ImperialSpaceSociety/Flight-Computer/Hardware/Documentation/Pinout_Stm32.xlsx

Module
Radio
PA0 | Radio_DIO1
PA1 | Radio_DIO0
PC1 | Radio_DIO2
PC8 | Radio_DIO3
PC7 | Radio_DIO4
PC6 | Radio_DIO5
PA2 | Radio_RX
PA4 | Radio_TX
PA5 | Radio_SPI1_SCK
PA6 | Radio_SPI1_MISO
PA7 | Radio_SPI1_MOSI
PC5 | Radio_Enable
SWD
PA13 | SYS_JTMS_SWDIO
PA14 | SYS_JTCK_SWCLK
Flash
PB2 | Flash_QUADSPI_CLK
PB6 | Flash_QUADSPI_BK1_NCS
PC9 | Flash_QUADSPI_BK1_IO0
PC10 | Flash_QUADSPI_BK1_IO1
GPS
PC11 | GPS_Reset
PC12 | GPS_UART_TX
PD2 | GPS_UART_RX
Indicator LED
PB9 | Indicator_LED
Battery Voltage Measurement
PC4 | Battery_Voltage
Buzzer
PA3 | Buzzer_Gate
USB
PA11 | USB_D-
PA12 | USB_D+
I2C
PB7 | I2C1_SDA
PB8 | I2C1_SCL
BMI088
PC14 | Acc_int1
PC15 | Gyro_int3
LIS3MDL
PA8 | Mag_Data_Ready
