ImperialSpaceSociety/Flight-Computer/Software/serial_logging/processing/Altitude.png

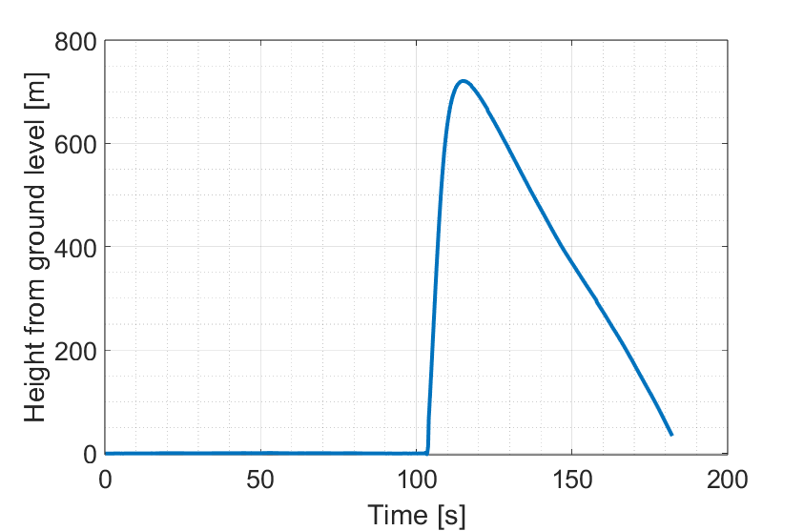
Software/serial_logging/processing/Altitude.png
