ImperialSpaceSociety/Flight-Computer/Software/serial_logging/processing/Distance.png

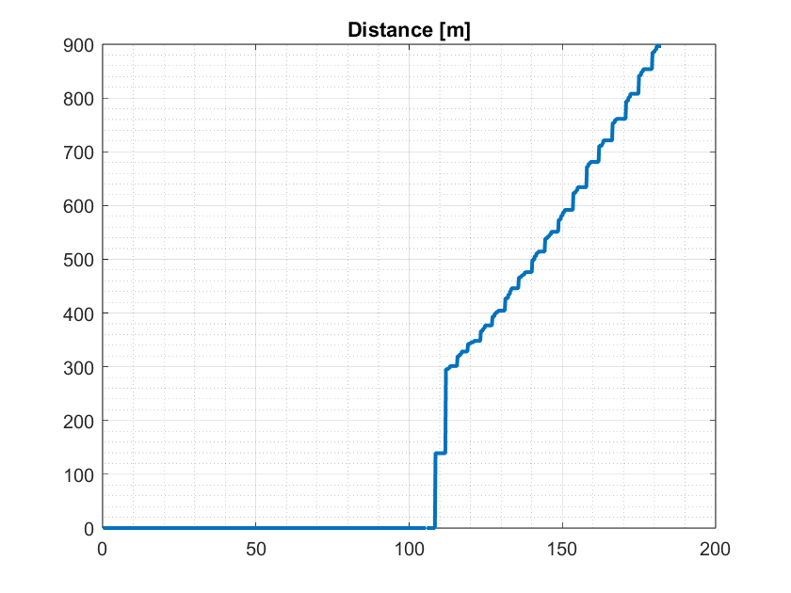
Software/serial_logging/processing/Distance.png
