ImperialSpaceSociety/Flight-Computer/Software/serial_logging/processing/Humidity.png

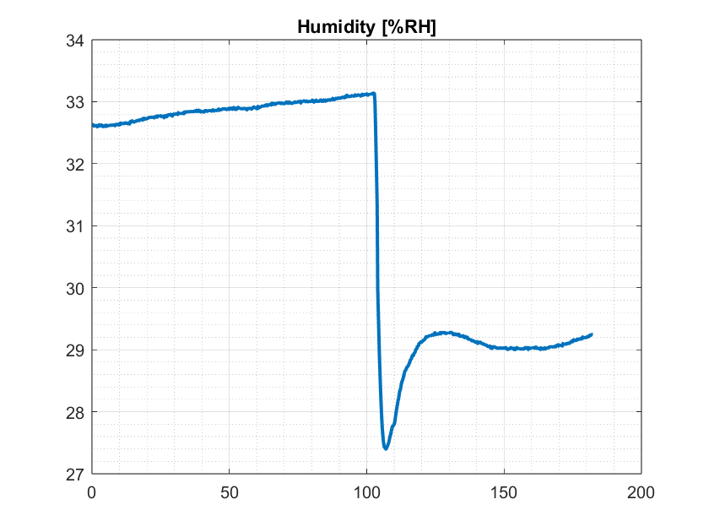
Software/serial_logging/processing/Humidity.png
