ImperialSpaceSociety/Flight-Computer/Software/serial_logging/processing/Map.png

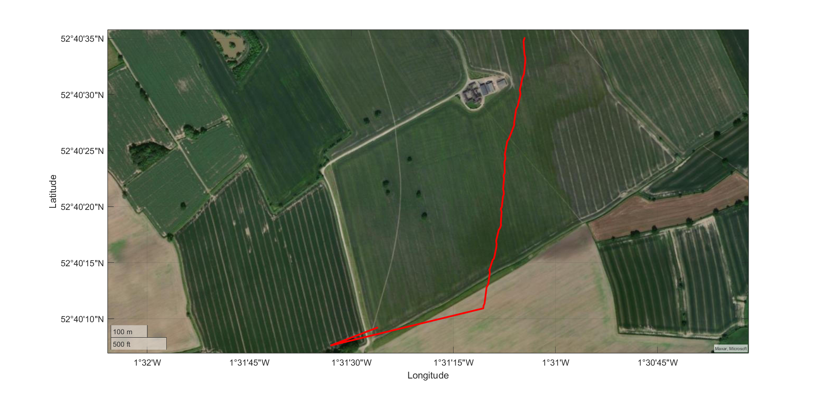
Software/serial_logging/processing/Map.png
