ImperialSpaceSociety/Flight-Computer/Software/serial_logging/processing/MapV2.png

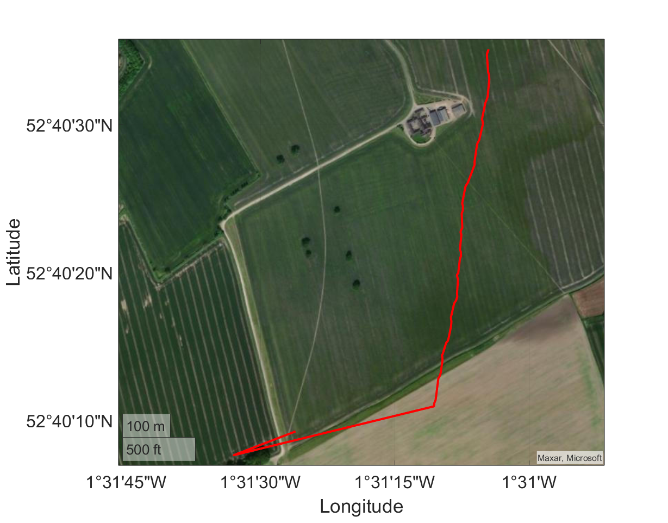
Software/serial_logging/processing/MapV2.png
