ImperialSpaceSociety/Flight-Computer/Software/serial_logging/processing/Pressure.png

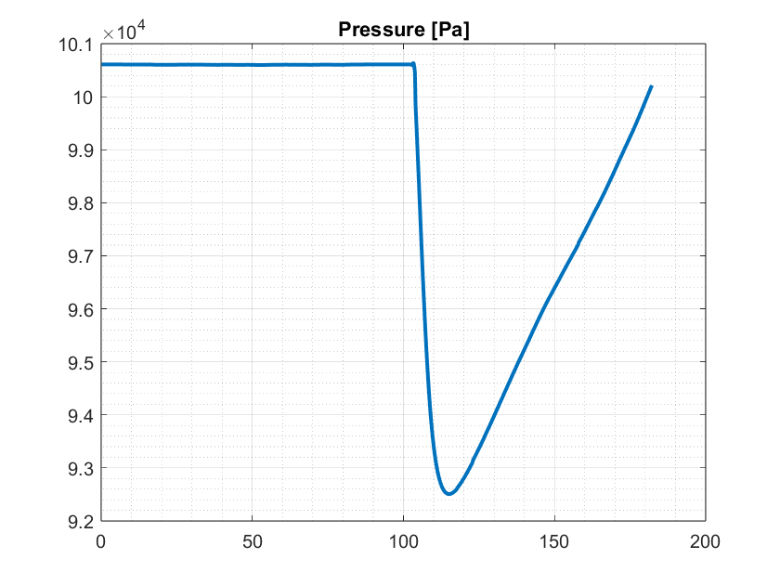
Software/serial_logging/processing/Pressure.png
