ImperialSpaceSociety/Flight-Computer/Software/serial_logging/processing/Temperature.png

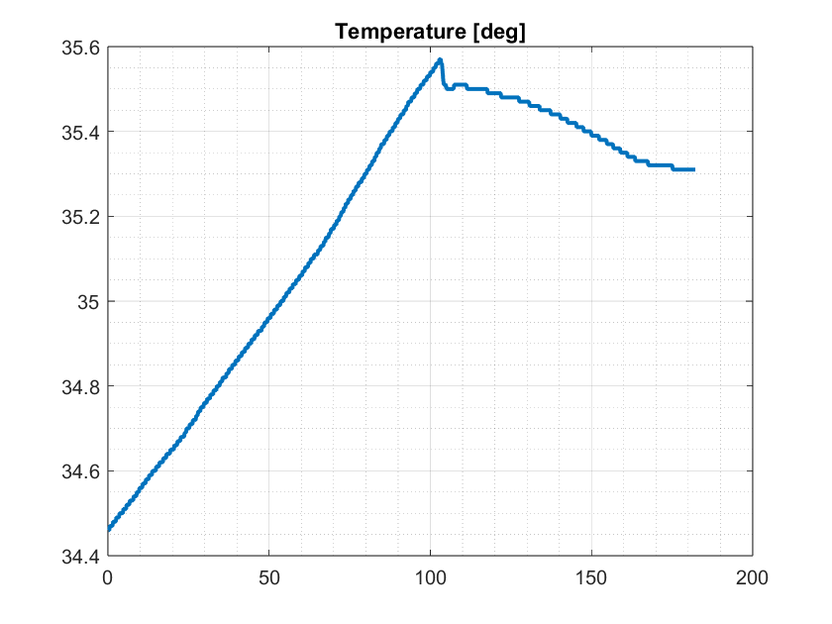
Software/serial_logging/processing/Temperature.png
