ImperialSpaceSociety/Flight-Computer/Hardware/Documentation/Bill_of_materials.xlsx

Sheet: circuit board design v2.1
Source: | C:\Users\timot\Documents\Programming\SpaceSoc\Flight-Computer\Hardware\circuit board design v2.1\circuit board design v2.1.kicad_sch
Date: | 2023-06-03 15:34
Tool: | Eeschema (6.0.8)
Generator: | C:\Program Files\KiCad\6.0\bin\scripting\plugins/bom_csv_grouped_by_value.py
Component Count: | 56
Individual Components:
Item | Qty | Reference(s) | Value | LibPart | Footprint | Datasheet | AVAILABILITY | Arrow Part Number | Arrow Price/Stock | DESCRIPTION | Datasheet_1 | Description | Footprint_1 | Height | MANUFACTURER | MAXIMUM_PACKAGE_HEIGHT | MF | MP | Manufacturer_Name | Manufacturer_Part_Number | Mouser Part Number | Mouser Price/Stock | PACKAGE | PARTREV | PRICE | Reference_1 | SNAPEDA_PACKAGE_ID | SNAPEDA_PN | STANDARD | Value_1
 |  | C1 | 100nF | Components:C_0603 | Components:C_0603_1608Metric | ~
 |  | C2 | 100nF | Components:C_0603 | Components:C_0603_1608Metric | ~
 |  | C3 | 1uF | Components:C_0603 | Components:C_0603_1608Metric | ~
 |  | C4 | 1uF | Components:C_0603 | Components:C_0603_1608Metric | ~
 |  | C5 | 100nF | Components:C_0603 | Components:C_0603_1608Metric | ~
 |  | C6 | 100nF | Components:C_0603 | Components:C_0603_1608Metric | ~
 |  | C7 | 100nF | Components:C_0603 | Components:C_0603_1608Metric | ~
 |  | C8 | 100nF | Components:C_0603 | Components:C_0603_1608Metric | ~
 |  | C9 | 4.7uF | Components:C_0603 | Components:C_0603_1608Metric | ~
 |  | C10 | 100nF | Components:C_0603 | Components:C_0603_1608Metric | ~
 |  | C11 | 1uF | Components:C_0603 | Components:C_0603_1608Metric | ~
 |  | C12 | 1uF | Components:C_0603 | Components:C_0603_1608Metric | ~
 |  | C13 | 100nF | Components:C_0603 | Components:C_0603_1608Metric | ~
 |  | C14 | 100nF | Components:C_0603 | Components:C_0603_1608Metric | ~
 |  | C15 | 100nF | Components:C_0603 | Components:C_0603_1608Metric | ~
 |  | C16 | 4.7uF Tantalum Capacitor | Device:C_Polarized_Small | Capacitor_SMD:C_1206_3216Metric_Pad1.33x1.80mm_HandSolder | ~
 |  | C17 | 15pF | Components:C_0603 | Components:C_0603_1608Metric | ~
 |  | C18 | 15pF | Components:C_0603 | Components:C_0603_1608Metric | ~
 |  | C19 | 100nF | Components:C_0603 | Components:C_0603_1608Metric | ~
 |  | C20 | 100nF | Components:C_0603 | Components:C_0603_1608Metric | ~
 |  | C21 | 100nF | Components:C_0603 | Components:C_0603_1608Metric | ~
 |  | C22 | 4.7uF | Components:C_0603 | Components:C_0603_1608Metric | ~
 |  | C23 | 100nF | Components:C_0603 | Components:C_0603_1608Metric | ~
 |  | C24 | 100nF | Components:C_0603 | Components:C_0603_1608Metric | ~
 |  | C27 | 100nF | Device:C_Small | Capacitor_SMD:C_0603_1608Metric_Pad1.08x0.95mm_HandSolder | ~
 |  | D1 | DFLS130L Schottkey Diode | Components:DFLS130L | Components:PowerDI123 | ~
 |  | D2 | DFLS130L Schottkey Diode | Components:DFLS130L | Components:PowerDI123 | ~
 |  | D3 | SML-LX0603GW-TR Green LED | Components:LED_0603 | Components:C_0603_1608Metric | ~
 |  | D4 | SML-LX0603IW-TR Red LED | Components:LED_0603 | Components:C_0603_1608Metric | ~
 |  | FB1 | 742792025 Ferrite Bead 120R@100MHz | Device:FerriteBead | Resistor_SMD:R_0805_2012Metric_Pad1.20x1.40mm_HandSolder | ~
 |  | J1 | 01x02_Male_PinHeader_2.54mm | Connector:Conn_01x02_Male | Connector_PinHeader_2.54mm:PinHeader_1x02_P2.54mm_Vertical | ~
 |  | J2 | JST_PH_S2B-PH-K_1x02_P2.00mm_Horizontal | Connector_Generic:Conn_01x02 | Components:JST_PH_S2B-PH-K_1x02_P2.00mm_Horizontal | ~
 |  | J3 | 105017-0001 Micro USB Conn | Components:105017-0001 | MOLEX_105017-0001 | https://www.mouser.co.uk/datasheet/2/276/1/1050170001_IO_CONNECTORS-230168.pdf
 |  | J4 | [OPTIONAL] U.FL-R-SMT-1_10_ Antenna Conn | Components:U.FL-R-SMT-1_10_ | Components:U.FL-R-SMT-1_10_ | https://www.hirose.com/product/document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 |  | U.FL-R-SMT-1(10) | https://www.arrow.com/en/products/u.fl-r-smt-1-10/hirose-electric |  | https://www.hirose.com/product/document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 |  | U.FL-R-SMT-1(10) |  |  |  |  |  | Hirose | U.FL-R-SMT-1(10) | 798-U.FL-R-SMT-110 | https://www.mouser.co.uk/ProductDetail/Hirose-Connector/U.FL-R-SMT-110?qs=kL1ClTr6oBoOdtqlGQpQrQ%3D%3D |  |  |  | J |  |  |  | U.FL-R-SMT-1_10_
 |  | J6 | 01x02_Male_PinHeader_2.54mm | Connector:Conn_01x02_Male | Connector_PinHeader_2.54mm:PinHeader_1x02_P2.54mm_Vertical | ~
 |  | R1 | 100k | Components:R_0603 | Components:R_0603_1608Metric | ~
 |  | R2 | 100k | Components:R_0603 | Components:R_0603_1608Metric | ~
 |  | R3 | 100 | Components:R_0603 | Components:R_0603_1608Metric | ~
 |  | R4 | 100 | Components:R_0603 | Components:R_0603_1608Metric | ~
 |  | R5 | 4.7k | Components:R_0603 | Components:R_0603_1608Metric | ~
 |  | R6 | 3.3k | Components:R_0603 | Components:R_0603_1608Metric | ~
 |  | R7 | 4.7k | Components:R_0603 | Components:R_0603_1608Metric | ~
 |  | R8 | 4.7k | Components:R_0603 | Components:R_0603_1608Metric | ~
 |  | U1 | STM32F446RETx | MCU_ST_STM32F4:STM32F446RETx | Components:LQFP-64_10x10mm_P0.5mm | http://www.st.com/st-web-ui/static/active/en/resource/technical/document/datasheet/DM00141306.pdf
 |  | U2 | W25Q64JVSS 64MBit Flash Chip | Components:W25Q64JVSS | Components:W25Q64JVSSIQ | https://www.winbond.com/resource-files/W25Q64JV%20RevK%2003102021%20Plus.pdf#toolbar=0
 |  | U3 | SDR08540M3-01 SMD Buzzer | Components:SDR08540M3-01 | Components:SDR08540M3-01 Buzzer | https://docs.rs-online.com/16ce/0900766b815934ae.pdf
 |  | U4 | BME280 Environment Sensor | Sensor:BME280 | Package_LGA:Bosch_LGA-8_2.5x2.5mm_P0.65mm_ClockwisePinNumbering | https://ae-bst.resource.bosch.com/media/_tech/media/datasheets/BST-BME280-DS002.pdf
 |  | U5 | STF202-22T1G ESD/EMI Chip | Components:STF202-22T1G | Components:STF202-22T1G
 |  | U6 | MAX40203_SOT23 Ideal Diode | Components:MAX40203_SOT23 | Package_TO_SOT_SMD:SOT-23-5
 |  | U7 | NCP161ASN330T1G LDO | Components:NCP161ASN180T1G | Components:SOT95P280X145-5N | https://www.mouser.co.uk/datasheet/2/308/1/NCP161_D-2316989.pdf |  |  |  |  |  |  |  |  | Onsemi | 1.45 mm |  |  |  |  |  |  |  | Rev. 18 |  |  |  | NCP161ASN180T1G | IPC-7351B
 |  | U8 | BMI088 Inertial Measurement Unit | Components:BMI088 | Components:BMI088 | https://datasheet.datasheetarchive.com/originals/distributors/Datasheets_SAMA/994c3bf88e91a9e9fead6a819d348e4d.pdf |  | BMI088 | https://www.arrow.com/en/products/bmi088/bosch?region=europe |  |  | Inertial Measurement Unit Digital Output 2.5V/3.3V Automotive |  | 1.45 |  |  |  |  | BOSCH | BMI088 | 262-BMI088 | https://www.mouser.co.uk/ProductDetail/Bosch-Sensortec/BMI088?qs=f9yNj16SXrIMFspTV6RB6Q%3D%3D
 |  | U9 | LIS3MDLTR Magnetometer | Components:LIS3MDLTR | Components:XDCR_LIS3MDLTR |  | Unavailable |  |  | LIS3MDL Series 3 Axis Â±2/Â±8/Â±12/Â±16 g 3.6V High Performance Magnetometer LGA-12 |  |  |  |  |  | 1mm | STMicroelectronics | LIS3MDLTR |  |  |  |  | VFLGA-12 STMicroelectronics | 6 | None |  |  |  | Manufacturer Recommendation
 |  | U10 | LAMBDA-9D Radio | Components:LAMBDA-9D | Components:XCVR_LAMBDA-9D |  |  |  |  |  |  |  |  |  | RF Solutions | 5.81 mm |  |  |  |  |  |  |  | N/A |  |  | 63698 | LAMBDA-9D | Manufacturer Recommendations
 |  | U11 | 2SCR512R_HZG BJT | Components:2SCR512R_HZG | Components:2SCR512RHZG | https://fscdn.rohm.com/en/products/databook/datasheet/discrete/transistor/bipolar/2scr512rhzgtl-e.pdf
 |  | U12 | L80-R GPS | Components:L80-R | Components:Quectel_L80-R | https://www.quectel.com/UploadImage/Downlad/Quectel_L80-R_Hardware_Design_V1.2.pdf
 |  | Y1 | ECS-80-8-33Q-ADS-TR3 8MHz Crystal | Device:Crystal_GND24 | Components:ECS-80-8-33Q-ADS-TR3 Crystal | ~
Collated Components:
Item | Qty | Reference(s) | Value |  |  |  |  |  |  |  |  |  |  |  |  |  |  |  |  |  |  |  |  |  |  |  |  |  | STANDARD | Value_1
1 | 15 | C1, C2, C5, C6, C7, C8, C10, C13, C14, C15, C19, C20, C21, C23, C24 | 100nF
2 | 4 | C3, C4, C11, C12 | 1uF
3 | 2 | C9, C22 | 4.7uF
4 | 1 | C16 | 4.7uF Tantalum Capacitor
5 | 2 | C17, C18 | 15pF
6 | 1 | C27 | 100nF
7 | 2 | D1, D2 | DFLS130L Schottkey Diode
8 | 1 | D3 | SML-LX0603GW-TR Green LED
9 | 1 | D4 | SML-LX0603IW-TR Red LED
10 | 1 | FB1 | 742792025 Ferrite Bead 120R@100MHz
11 | 2 | J1, J6 | 01x02_Male_PinHeader_2.54mm
12 | 1 | J2 | JST_PH_S2B-PH-K_1x02_P2.00mm_Horizontal
13 | 1 | J3 | 105017-0001 Micro USB Conn
14 | 1 | J4 | [OPTIONAL] U.FL-R-SMT-1_10_ Antenna Conn
15 | 2 | R1, R2 | 100k
16 | 2 | R3, R4 | 100
17 | 3 | R5, R7, R8 | 4.7k
18 | 1 | R6 | 3.3k
19 | 1 | U1 | STM32F446RETx
20 | 1 | U2 | W25Q64JVSS 64MBit Flash Chip
21 | 1 | U3 | SDR08540M3-01 SMD Buzzer
22 | 1 | U4 | BME280 Environment Sensor
23 | 1 | U5 | STF202-22T1G ESD/EMI Chip
24 | 1 | U6 | MAX40203_SOT23 Ideal Diode
25 | 1 | U7 | NCP161ASN330T1G LDO
26 | 1 | U8 | BMI088 Inertial Measurement Unit
27 | 1 | U9 | LIS3MDLTR Magnetometer
28 | 1 | U10 | LAMBDA-9D Radio
29 | 1 | U11 | 2SCR512R_HZG BJT
30 | 1 | U12 | L80-R GPS
31 | 1 | Y1 | ECS-80-8-33Q-ADS-TR3 8MHz Crystal

Sheet: Collated items
Item | Qty | Reference(s) | Value | Link | Unit cost | No. required | No. available | No. to purchase | No. expected | Price for part | Ordered? | Received?
1 | 15 | C1, C2, C5, C6, C7, C8, C10, C13, C14, C15, C19, C20, C21, C23, C24 | 100nF 0603YC104J4T4A | https://www.mouser.co.uk/ProductDetail/KYOCERA-AVX/0603YC104J4T4A?qs=Cej1j9ztgjFyuPBXcKRKGA%3D%3D | 0.131 | 45 | 19 | 30 | 49 | 3.93 | Yes
2 | 4 | C3, C4, C11, C12 | 1uF |  |  | 12 | 50 | 0 | 50 | 0
3 | 2 | C9, C22 | 4.7uF | https://www.mouser.co.uk/ProductDetail/KYOCERA-AVX/0603YW475KAT2A?qs=iLbezkQI%252BsjdoT7nJYA5eA%3D%3D |  | 6 | 15 | 0 | 15 | 0
4 | 1 | C16 | 4.7uF Tantalum Capacitor | https://www.mouser.co.uk/ProductDetail/KYOCERA-AVX/TPSA475M010R1400?qs=70AbZ74NqZZa2PI6j%2F762Q%3D%3D |  | 3 | 18 | 0 | 18 | 0
5 | 2 | C17, C18 | 15pF 06031A150FAT2A | https://www.mouser.co.uk/ProductDetail/KYOCERA-AVX/06031A150FAT2A?qs=xLQ2B4dN2oaD6%252BZaTtyi8g%3D%3D | 0.175 | 6 | 0 | 10 | 10 | 1.75 | Yes
6 | 1 | C27 | 100nF |  |  | 3 | 3 | 0 | 3 | 0
7 | 2 | D1, D2 | DFLS130L Schottkey Diode | https://www.mouser.co.uk/ProductDetail/Diodes-Incorporated/DFLS130L-7?qs=JV7lzlMm3yLedTETABmZ1A%3D%3D | 0.372 | 6 | 43 | 0 | 43 | 0
8 | 1 | D3 | SML-LX0603GW-TR Green LED | https://www.mouser.co.uk/ProductDetail/Lumex/SML-LX0603GW-TR?qs=Ma3pWdXK8s%252BAlupi7PYUJg%3D%3D | 0.181 | 3 | 0 | 10 | 10 | 1.81 | Yes
9 | 1 | D4 | SML-LX0603IW-TR Red LED | https://www.mouser.co.uk/ProductDetail/Lumex/SML-LX0603IW-TR?qs=Ma3pWdXK8s%2FPxoga78z1xA%3D%3D | 0.173 | 3 | 0 | 10 | 10 | 1.73 | Yes
10 | 1 | FB1 | 742792025 Ferrite Bead 120R@100MHz | https://www.mouser.co.uk/ProductDetail/Wurth-Elektronik/742792025?qs=amGC7iS6iy%252BaTNFi8olptQ%3D%3D | 0.19 | 3 | 7 | 0 | 7 | 0
11 | 2 | J1, J6 | 01x02_Male_PinHeader_2.54mm |  |  | 6 | 40 | 0 | 40 | 0
12 | 1 | J2 | JST_PH_S2B-PH-K_1x02_P2.00mm_Horizontal | https://www.mouser.co.uk/ProductDetail/SparkFun/PRT-09749 | 0.786 | 3 | 0 | 5 | 5 | 3.93 | Yes
13 | 1 | J3 | 105017-0001 Micro USB Conn | https://www.mouser.co.uk/ProductDetail/Molex/105017-0001?qs=hlXxxvYE36k7QcsR97GUKA%3D%3D | 0.769 | 3 | 0 | 3 | 3 | 2.307 | Yes
14 | 1 | J4 | [OPTIONAL] U.FL-R-SMT-1_10_ Antenna Conn | https://www.mouser.co.uk/ProductDetail/Hirose-Connector/U.FL-R-SMT-110?qs=kL1ClTr6oBoOdtqlGQpQrQ%3D%3D | 1.04 | 3 | 0 | 3 | 3 | 3.12 | Yes
15 | 2 | R1, R2 | 100k | https://www.mouser.co.uk/ProductDetail/Bourns/CR0603AFX-1003EAS?qs=PzGy0jfpSMt3RNxQD3lIYw%3D%3D | 0.083 | 6 | 16 | 0 | 16 | 0
16 | 2 | R3, R4 | 100 | https://www.mouser.co.uk/ProductDetail/ROHM-Semiconductor/ESR03EZPF1000?qs=493kPxzlxfJdLkJZpX4ByA%3D%3D | 0.106 | 6 | 0 | 10 | 10 | 1.06 | Yes
17 | 3 | R5, R7, R8 | 4.7k |  |  | 9 | 35 | 0 | 35 | 0
18 | 1 | R6 | 3.3k |  |  | 3 | 50 | 0 | 50 | 0
19 | 1 | U1 | STM32F446RET6 MCU | https://www.mouser.co.uk/ProductDetail/511-STM32F446RET6 | 10.02 | 3 | 0 | 3 | 3 | 30.06 | Yes
20 | 1 | U2 | W25Q64JVSSIM 64MBit Flash Chip | https://www.mouser.co.uk/ProductDetail/Winbond/W25Q64JVSSIM?qs=qSfuJ%252Bfl%2Fd7U0hcTKxbcpQ%3D%3D | 0.924 | 3 | 1 | 3 | 4 | 2.772 | Yes
21 | 1 | U3 | SDR08540M3-01 SMD Buzzer | https://www.mouser.co.uk/ProductDetail/TDK/SDR08540M3-01?qs=HCSEz3Yk0hVXXjPeUNGg%252Bw%3D%3D | 2.79 | 3 | 0 | 3 | 3 | 8.37 | Yes
22 | 1 | U4 | BME280 Environment Sensor | https://www.mouser.co.uk/ProductDetail/Bosch-Sensortec/BME280?qs=2OnyuXx6vpj2fK9HX7qb3g%3D%3D | 5.36 | 3 | 0 | 3 | 3 | 16.08 | Yes
23 | 1 | U5 | STF202-22T1G ESD/EMI Chip | https://www.mouser.co.uk/ProductDetail/onsemi/STF202-22T1G?qs=xZq1yRCsb1dM1UQ1NtNRtw%3D%3D | 0.472 | 3 | 0 | 5 | 5 | 2.36 | Yes
24 | 1 | U6 | MAX40203AUK+T Ideal Diode | https://www.mouser.co.uk/ProductDetail/Analog-Devices-Maxim-Integrated/MAX40203AUK%2bT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 | 0.959 | 3 | 0 | 5 | 5 | 4.795 | Yes
25 | 1 | U7 | NCP161ASN330T1G LDO | https://www.mouser.co.uk/ProductDetail/onsemi/NCP161ASN330T1G?qs=vLWxofP3U2ze5zA%252BHmAd3w%3D%3D | 0.554 | 3 | 0 | 5 | 5 | 2.77 | Yes
26 | 1 | U8 | BMI088 Inertial Measurement Unit | https://www.mouser.co.uk/ProductDetail/Bosch-Sensortec/BMI088?qs=f9yNj16SXrIMFspTV6RB6Q%3D%3D | 6.91 | 3 | 0 | 3 | 3 | 20.73 | Yes
27 | 1 | U9 | LIS3MDLTR Magnetometer | https://www.mouser.co.uk/ProductDetail/STMicroelectronics/LIS3MDLTR?qs=hnsWAVXnr6EbLE48dGN9Pg%3D%3D | 3.79 | 3 | 0 | 3 | 3 | 11.37 | Yes
28 | 1 | U10 | LAMBDA-9D Radio | https://uk.farnell.com/rf-solutions/lambda-9s/rf-transceiver-module-300kbps/dp/2841160 | 17.13 | 3 | 0 | 3 | 3 | 51.39 | Yes
29 | 1 | U11 | 2SCR512RHZGTL BJT | https://www.mouser.co.uk/ProductDetail/ROHM-Semiconductor/2SCR512RHZGTL?qs=Znm5pLBrcALIry0mOIvBtQ%3D%3D | 0.579 | 3 | 0 | 5 | 5 | 2.895 | Yes
30 | 1 | U12 | L80-M39 GPS | https://www.digikey.com/en/products/detail/quectel/L80-M39/13278232 | 11.24 | 3 | 0 | 3 | 3 | 33.72 | Yes
31 | 1 | Y1 | ECS-80-8-33Q-ADS-TR3 8MHz Crystal | https://www.mouser.co.uk/ProductDetail/ECS/ECS-80-8-33Q-ADS-TR3?qs=vvQtp7zwQdPZhvH6k3gGMw%3D%3D | 0.803 | 3 | 0 | 5 | 5 | 4.015 | Yes
32 | 1 | - | Lipo battery | https://www.amazon.co.uk/EEMB-Battery-Lithium-Rechargeable-connector/dp/B0B5LF57SL?hvadid=621166234518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 | 9.99 | 3 | 0 | 3 | 3 | 29.97
 |  |  |  |  |  |  |  |  |  | 240.934
JLCPCB | 38.12
