ImperialSpaceSociety/Flight-Computer/Hardware/Documentation/Power_consumption.xlsx

Sheet: Sheet1
Component | Name | Datasheet |  |  | manufacturer
IMU | BNO055 (9DOF)
 | BMI088 (6DOF, but better vibration resistance and lower drift) | https://download.mikroe.com/documents/datasheets/BMI088_Datasheet.pdf | Module (qty: 1) (https://www.mouser.co.uk/ProductDetail/Bosch-Sensortec/BMI088-Shuttle-Board-3.0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) |  | Module (qty: 1)
Magnetometer | LIS3MDL |  | Module (qty: 1) (https://www.mouser.co.uk/ProductDetail/Adafruit/4479?qs=CUBnOrq4ZJxLqbe7QDjUXQ%3D%3D)
Temp, Pressure, Humidity | BME280 | https://www.mouser.com/datasheet/2/783/BST-BME280-DS002-1509607.pdf
GPS | UBLOX MAX-M10 | Documentation (https://www.u-blox.com/en/product/max-m10-series)
 | Quectel L80-M39 | https://www.mouser.co.uk/datasheet/2/1052/QWSC_S_A0004134860_1-2576267.pdf | Module (qty: 1) (https://uk.rs-online.com/web/p/gnss-gps-modules/9084085)
Radio | LAMBDA-9P | Module (qty: 2) (https://uk.rs-online.com/web/p/lpwan/1812477) | Antenna (qty: 2) (https://uk.rs-online.com/web/p/telemetry-antennas/1767074) | SMA-IPEX Adapter (qty: 3) (https://uk.rs-online.com/web/p/coaxial-cable/1408015)
 | DIGI XTEND 1W (900Mhz)
Flash | W25Q64JV | Datasheet (https://www.winbond.com/resource-files/W25Q64JV%20RevK%2003102021%20Plus.pdf) | Chip (qty: 5) (https://www.mouser.co.uk/ProductDetail/Winbond/W25Q64JVSSIM?qs=qSfuJ%252Bfl%2Fd7U0hcTKxbcpQ%3D%3D) | Adapter (qty: 2) (https://www.mouser.co.uk/ProductDetail/Chip-Quik/PA0001?qs=gjT6naH6P5KNp1oSqw9XfQ%3D%3D)
Battery
Buzzer | TDK 88dB SMD High Internal Magnetic Buzzer Component | Link (https://docs.rs-online.com/16ce/0900766b815934ae.pdf)
MCU | STM32F446RE | Documentation (https://www.st.com/en/microcontrollers-microprocessors/stm32f446re.html)
 |  | Dev board (Nucleo) (https://www.mouser.co.uk/ProductDetail/511-NUCLEO-F446RE)

Sheet: BOM
Part | Price per unit | Quanitity | Price | Link | Number | Farnell link | Final check | Check if received | Not needed
STM32F446RET6 | 10.02 | 1 | 10.02 | https://www.mouser.co.uk/ProductDetail/511-STM32F446RET6 | 21 | https://uk.farnell.com/stmicroelectronics/stm32f446ret6/mcu-32bit-cortex-m4f-180mhz-lqfp/dp/2488310 | x | x | 13
SDR08540M3-01 | 2.79 | 1 | 2.79 | https://www.mouser.co.uk/ProductDetail/TDK/SDR08540M3-01?qs=HCSEz3Yk0hVXXjPeUNGg%252Bw%3D%3D | 23 |  | x | x | 16
BME280 | 5.36 | 1 | 5.36 | https://www.mouser.co.uk/ProductDetail/Bosch-Sensortec/BME280?qs=2OnyuXx6vpj2fK9HX7qb3g%3D%3D | 24 |  | x | x | 22 | Already bought the flash clip
STF202-22T1G | 0.472 | 1 | 0.472 | https://www.mouser.co.uk/ProductDetail/onsemi/STF202-22T1G?qs=xZq1yRCsb1dM1UQ1NtNRtw%3D%3D | 25 |  | x | x
MAX40203AUK+T | 0.959 | 1 | 0.959 | https://www.mouser.co.uk/ProductDetail/Analog-Devices-Maxim-Integrated/MAX40203AUK%2bT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 | 26 |  | x | x
NCP161ASN330T1G | 0.554 | 1 | 0.554 | https://www.mouser.co.uk/ProductDetail/onsemi/NCP161ASN330T1G?qs=vLWxofP3U2ze5zA%252BHmAd3w%3D%3D | 27 |  | x | x
L80-M39 | 12.65 | 1 | 12.65 | https://www.mouser.co.uk/ProductDetail/Quectel/L80-M39?qs=GedFDFLaBXEPqYfo45AE6g%3D%3D | 28 |  | x | Didn’t get it since it is only sold to business customers
LIS3MDLTR | 3.79 | 1 | 3.79 | https://www.mouser.co.uk/ProductDetail/STMicroelectronics/LIS3MDLTR?qs=hnsWAVXnr6EbLE48dGN9Pg%3D%3D | 29 | https://uk.farnell.com/stmicroelectronics/lis3mdltr/magnetic-sensor-4-8-12-16g-lga/dp/2433083 | x | x
ECS-80-8-33Q-ADS-TR3 | 0.803 | 1 | 0.803 | https://www.mouser.co.uk/ProductDetail/ECS/ECS-80-8-33Q-ADS-TR3?qs=vvQtp7zwQdPZhvH6k3gGMw%3D%3D | 30 |  | x | x
DFLS130L | 0.372 | 10 | 3.72 | https://www.mouser.co.uk/ProductDetail/Diodes-Incorporated/DFLS130L-7?qs=JV7lzlMm3yLedTETABmZ1A%3D%3D | 8 and 9 | https://uk.farnell.com/diodes-inc/dfls130lq-7/schottky-rect-single-30v-powerdi/dp/3127296?st=dfls130l | x | x
BMI088 | 6.91 | 1 | 6.91 | https://www.mouser.co.uk/ProductDetail/Bosch-Sensortec/BMI088?qs=f9yNj16SXrIMFspTV6RB6Q%3D%3D | 12 |  | x | x
2SCR512RHZGTL | 0.579 | 1 | 0.579 | https://www.mouser.co.uk/ProductDetail/ROHM-Semiconductor/2SCR512RHZGTL?qs=Znm5pLBrcALIry0mOIvBtQ%3D%3D | 17 |  | x | x
742792025 | 0.19 | 5 | 0.95 | https://www.mouser.co.uk/ProductDetail/Wurth-Elektronik/742792025?qs=amGC7iS6iy%252BaTNFi8olptQ%3D%3D | 10 | https://uk.farnell.com/wurth-elektronik/742792025/ferrite-bead-suppression-120-ohm/dp/4065718 | x | x
105017-0001 | 0.786 | 1 | 0.786 | https://www.mouser.co.uk/ProductDetail/Molex/105017-0001?qs=hlXxxvYE36k7QcsR97GUKA%3D%3D | 15 |  | x | x
U.FL-R-SMT-1(10) | 1.04 | 1 | 1.04 | https://www.mouser.co.uk/ProductDetail/Hirose-Connector/U.FL-R-SMT-110?qs=kL1ClTr6oBoOdtqlGQpQrQ%3D%3D |  |  | x | x
 |  |  | 0
4.7uF Capacitor 0603YW475KAT2A | 0.161 | 10 | 1.61 | https://www.mouser.co.uk/ProductDetail/KYOCERA-AVX/0603YW475KAT2A?qs=iLbezkQI%252BsjdoT7nJYA5eA%3D%3D | 3 |  | x | x
4.7uF Tantalum Capacitor TPSA475M010R1400 | 0.231 | 10 | 2.31 | https://www.mouser.co.uk/ProductDetail/KYOCERA-AVX/TPSA475M010R1400?qs=70AbZ74NqZZa2PI6j%2F762Q%3D%3D | 4 | https://uk.farnell.com/avx/tpsa475m010r1400/cap-4-7-f-10v-20/dp/2852790 | x | x
100k Resistor CR0603AFX-1003EAS | 0.033 | 10 | 0.33 | https://www.mouser.co.uk/ProductDetail/Bourns/CR0603AFX-1003EAS?qs=PzGy0jfpSMt3RNxQD3lIYw%3D%3D | 18 |  | x | x
EEMB Lithium Polymer battery 3.7V 600mAh 503042 Lipo Rechargeable Battery Pack with wire JST Connector | 7.89 | 1 | 7.89 | https://www.amazon.co.uk/dp/B095VW1RB8?s=electronics&sp_csd=d2lkZ2V0TmFtZT1zcF9kZXRhaWw
JST-PH 2 Wire Assembly | 0.6 | 5 | 3 | https://shop.pimoroni.com/products/jst-2-wire-assembly?variant=711377809&currency=GBP | 13
100nF Capacitors |  | 20 | 0 |  |  | https://uk.farnell.com/multicomp-pro/mcsh18b104k500ct/cap-0-1-f-50v-10-x7r-0603/dp/1856385 | x | x
 |  |  | 0
 |  |  | 0
 |  |  | 0
 |  |  | 0
 |  |  | 66.523
Existing parts (All parts 0603 exept if specified otherwise)
4.7k Resistor |  | Plenty |  |  | 19
3.3k Resistor |  | Plenty
15pF Capacitor |  | Some |  |  | 5
100nF Capacitor |  | Plenty |  |  | 1
10uF Capacitor |  | Plenty
33nF Capacitor |  | Plenty
1uF Capacitor |  | Plenty |  |  | 2,6,7
1 Resistor |  | Some

Sheet: power cossumption
Component | Voltage (V) | Current (mA) | Power (mW) | comment
BMI088 | 3.3 | 5.15 | 17.00
LIS3MDL | 3.3 | 0.27 | 0.89 | estimation the component might change
BME280 | 3.3 | 0.71 | 2.36 | (assuming measurement are done sequentially for temp, humidity and pressure
Quectel L80-M39 | 3.3 | 25.00 | 82.50
LAMBDA-9P (+17dBm PA Boost) | 3.3 | 90.00 | 297.00
W25Q64JV | 3.3 | 5.00 | 16.50
TDK 88dB | 3.3 | 85.00 | 280.50
STM32F446RE (90Mhz @ 25Deg) | 3.3 | 45.32 | 149.56
Total |  | 256.45 | 846.30
time of the flight | 1
Battery cap | 256.454
Calculating time of flight from batter cap | 187.1680691
