ImperialSpaceSociety/Flight-Computer/Hardware/circuit board design v2.1/Component_3d_models/SAM-M10Q-00B.stp

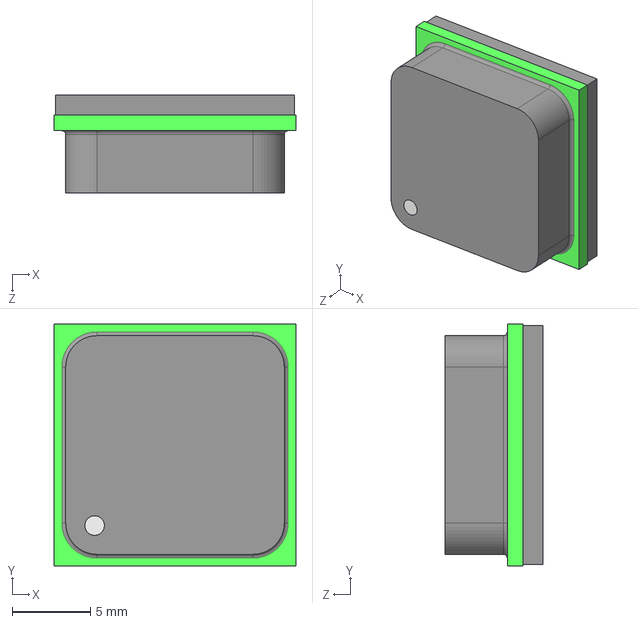
[picture p12: CAD file, 2023-05-27]
Hardware/circuit board design v2.1/Component_3d_models/SAM-M10Q-00B.stp
15.5 x 15.5 x 6.30 mm
