ImperialSpaceSociety/Flight-Computer/Hardware/enclosure/Electronics+Bay+V2+PCB.stl

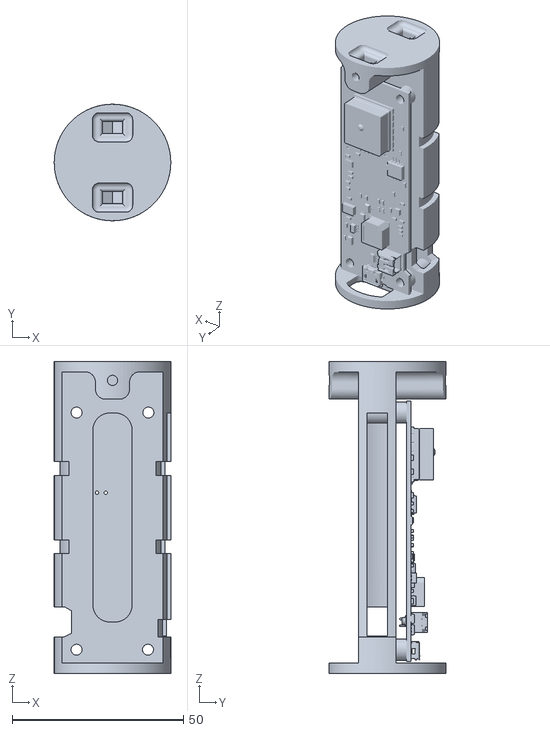
[picture p13: CAD file, 2024-07-31]
Hardware/enclosure/Electronics+Bay+V2+PCB.stl
34.0 x 34.0 x 91.0
