ImperialSpaceSociety/Flight-Computer/Hardware/circuit board design v2.1/Component_3d_models/C_0603_1608Metric.step

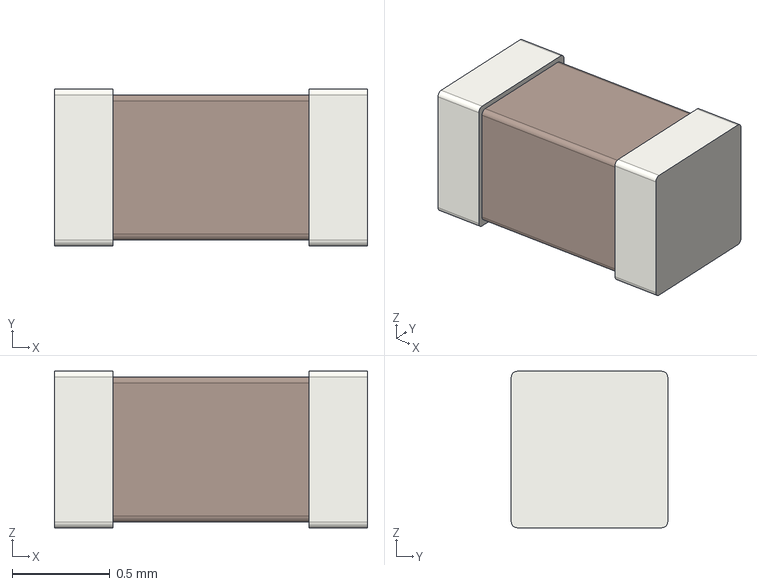
[picture p14: CAD file, 2023-05-27]
Hardware/circuit board design v2.1/Component_3d_models/C_0603_1608Metric.step
1.60 x 0.8 x 0.8 mm
