ImperialSpaceSociety/Flight-Computer/Hardware/circuit board design v2.1/Component_3d_models/2SCR512RHZG.step

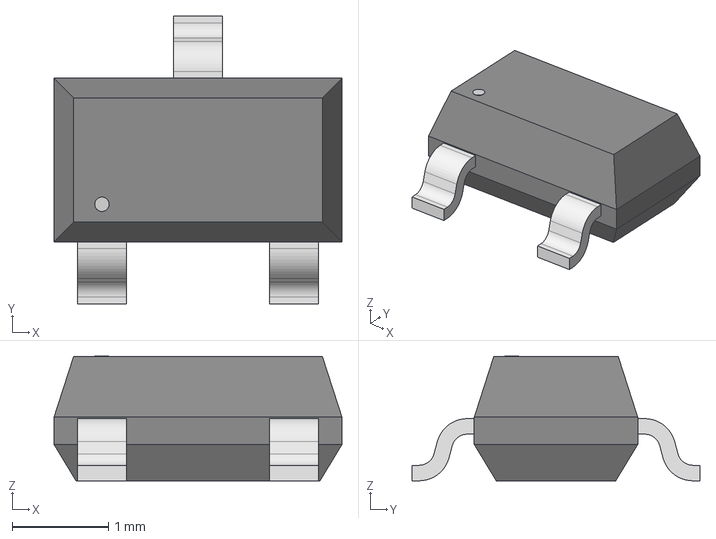
[picture p15: CAD file, 2023-05-04]
Hardware/circuit board design v2.1/Component_3d_models/2SCR512RHZG.step
3.00 x 3.00 x 1.30 mm
