ImperialSpaceSociety/Flight-Computer/Hardware/circuit board design v2.1/Component_3d_models/U.FL-R-SMT-1_10_.stp

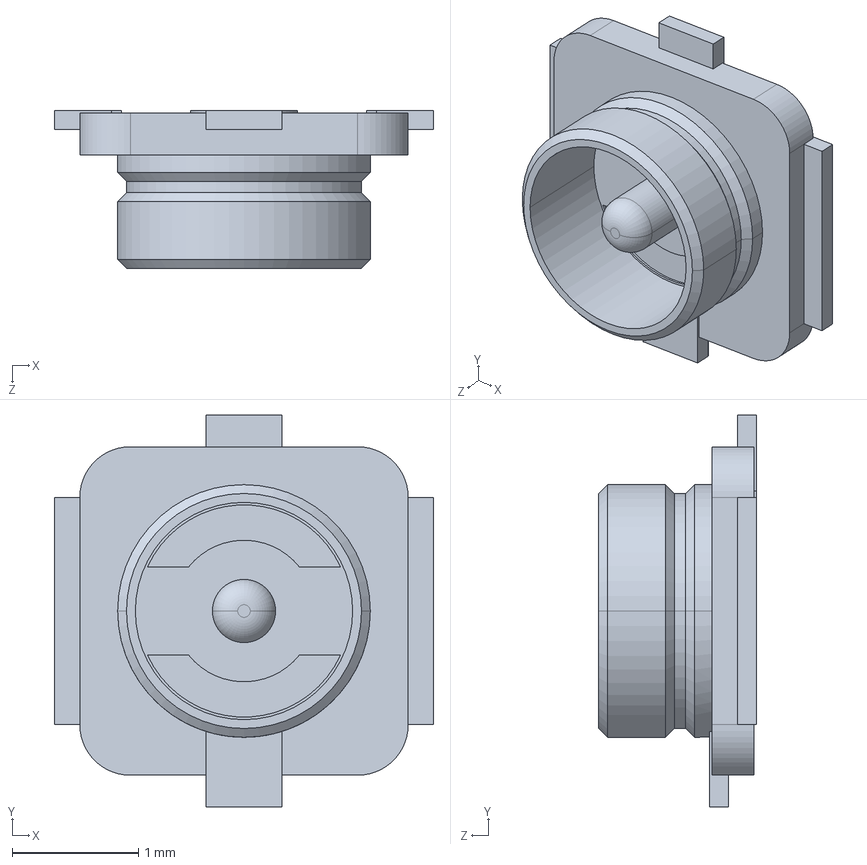
[picture p16: CAD file, 2023-05-04]
Hardware/circuit board design v2.1/Component_3d_models/U.FL-R-SMT-1_10_.stp
3.00 x 3.10 x 1.25 mm
