ImperialSpaceSociety/Flight-Computer/Hardware/circuit board design v2.1/Component_3d_models/LIS3MDLTR.step

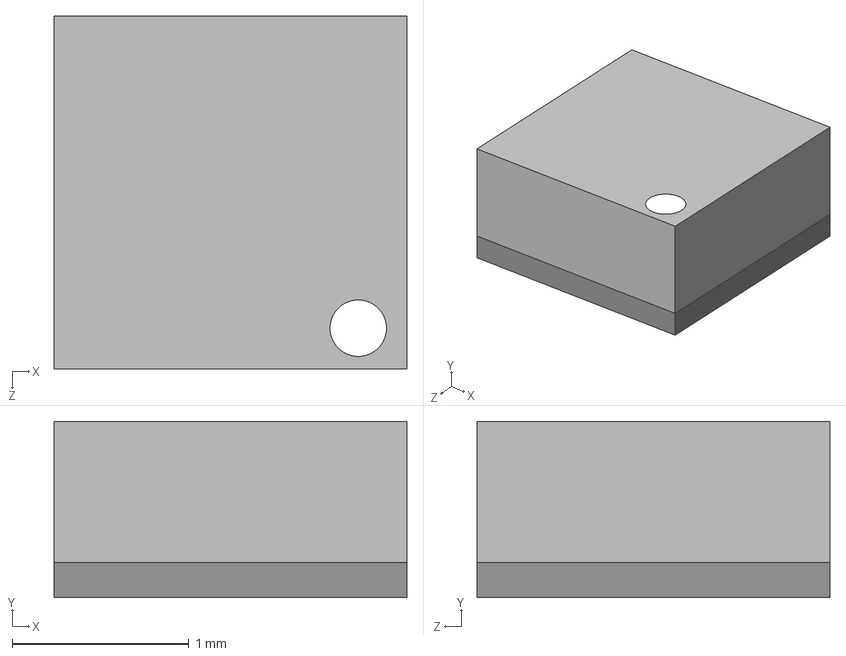
[picture p17: CAD file, 2023-04-30]
Hardware/circuit board design v2.1/Component_3d_models/LIS3MDLTR.step
2.00 x 1.00 x 2.00 mm
