ImperialSpaceSociety/Flight-Computer/Hardware/circuit board design v2.1/Component_3d_models/DF13-10P-1.25DS_20_.stp

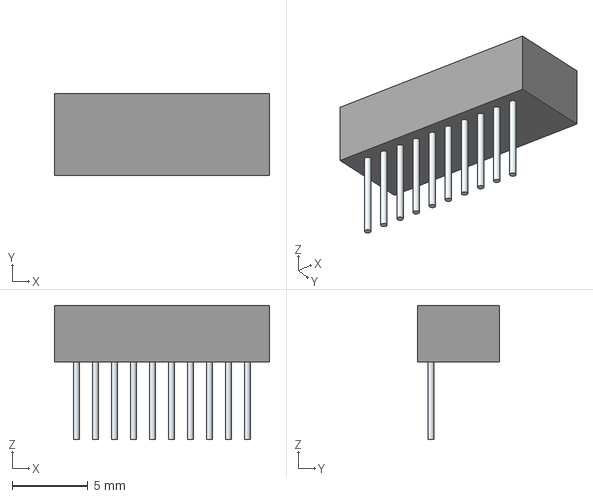
[picture p18: CAD file, 2023-04-30]
Hardware/circuit board design v2.1/Component_3d_models/DF13-10P-1.25DS_20_.stp
14.1 x 5.40 x 8.85 mm
Leads
