ImperialSpaceSociety/Flight-Computer/Hardware/circuit board design v2.1/Component_3d_models/JST_PH_S2B-PH-K_1x02_P2.00mm_Horizontal.step

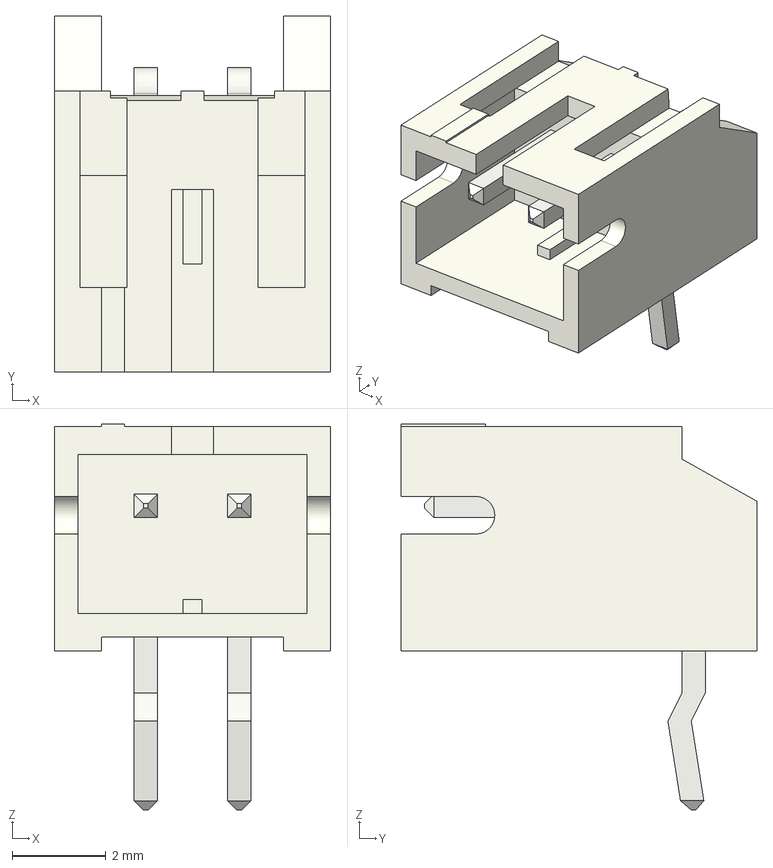
[picture p19: CAD file, 2023-04-23]
Hardware/circuit board design v2.1/Component_3d_models/JST_PH_S2B-PH-K_1x02_P2.00mm_Horizontal.step
5.90 x 7.60 x 8.25 mm
