ImperialSpaceSociety/Flight-Computer/Hardware/circuit board design v2.1/Component_3d_models/JST_PH_S4B-PH-K_1x04_P2.00mm_Horizontal.step

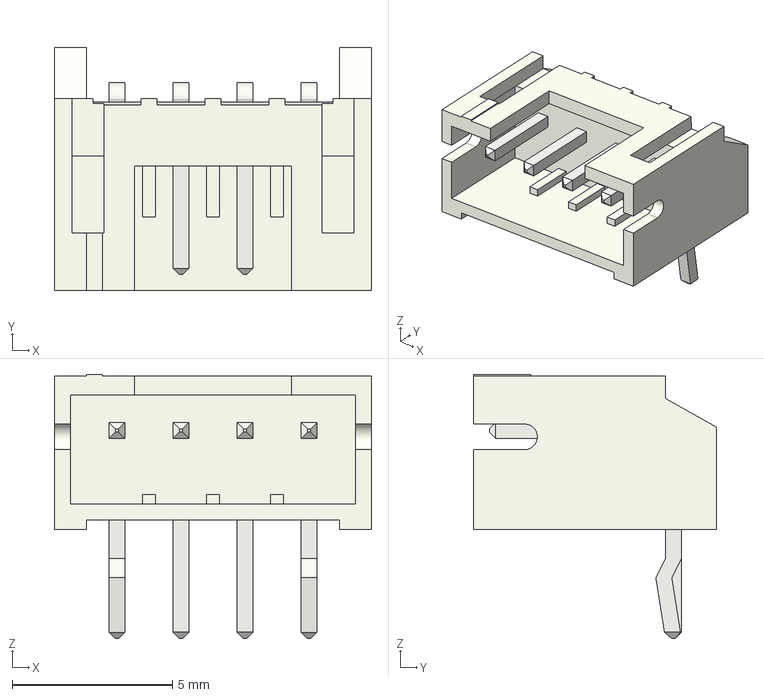
[picture p20: CAD file, 2023-04-23]
Hardware/circuit board design v2.1/Component_3d_models/JST_PH_S4B-PH-K_1x04_P2.00mm_Horizontal.step
9.90 x 7.60 x 8.25 mm
