ImperialSpaceSociety/Flight-Computer/Hardware/circuit board design v2.1/Component_3d_models/NCP161ASN180T1G.stp

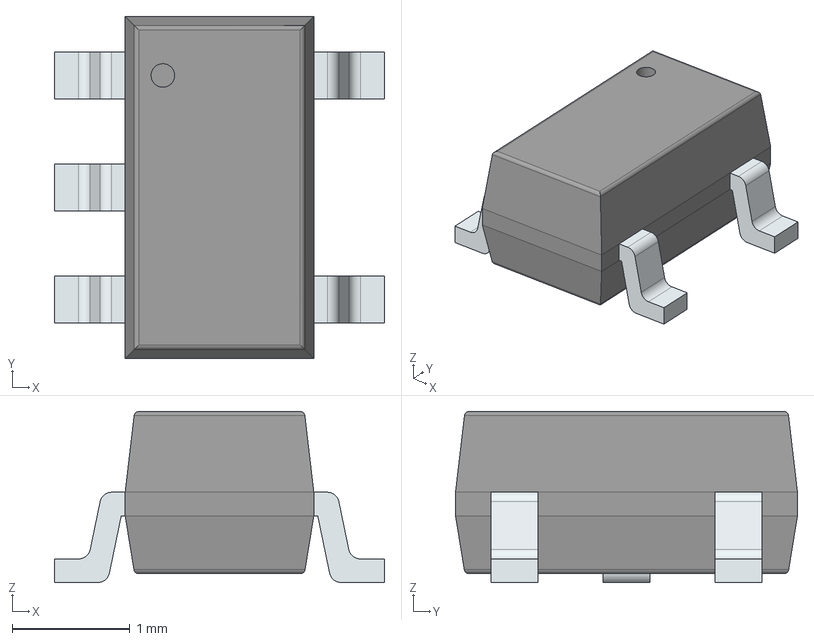
[picture p21: CAD file, 2023-04-22]
Hardware/circuit board design v2.1/Component_3d_models/NCP161ASN180T1G.stp
2.80 x 2.90 x 1.45 mm
PinsArrayL
PinsArrayR
