ImperialSpaceSociety/Flight-Computer/Hardware/circuit board design v2.1/Component_3d_models/TSOP-6_1.65x3.05mm_P0.95mm.step

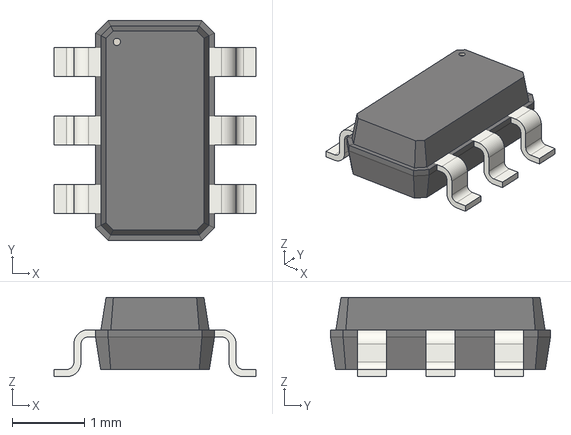
[picture p22: CAD file, 2023-04-22]
Hardware/circuit board design v2.1/Component_3d_models/TSOP-6_1.65x3.05mm_P0.95mm.step
2.80 x 3.05 x 1.10 mm
