ImperialSpaceSociety/Flight-Computer/Hardware/circuit board design v2.1/Component_3d_models/JST_PH_B2B-PH-K_1x02_P2.00mm_Vertical.step

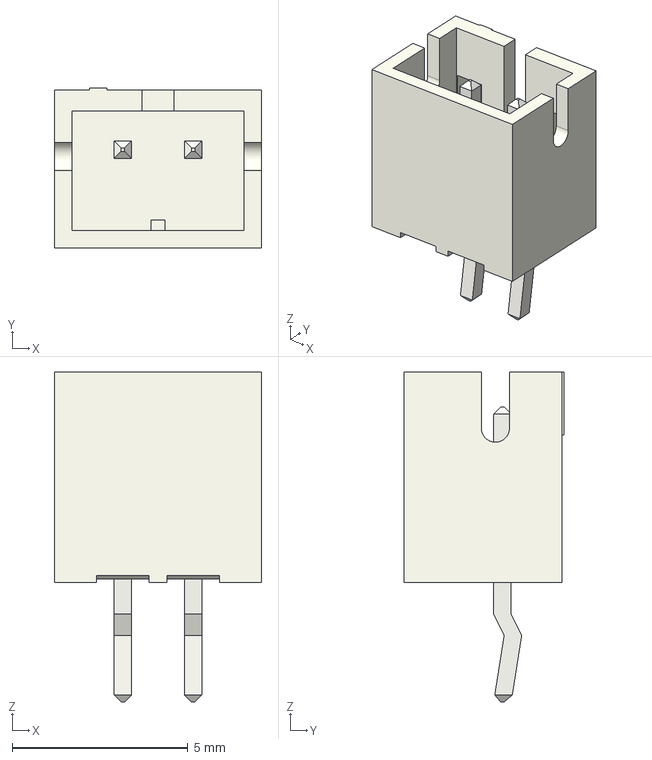
[picture p23: CAD file, 2023-04-08]
Hardware/circuit board design v2.1/Component_3d_models/JST_PH_B2B-PH-K_1x02_P2.00mm_Vertical.step
5.90 x 4.55 x 9.40 mm
