ImperialSpaceSociety/Flight-Computer/Hardware/circuit board design v2.1/Component_3d_models/R_0603_1608Metric.step

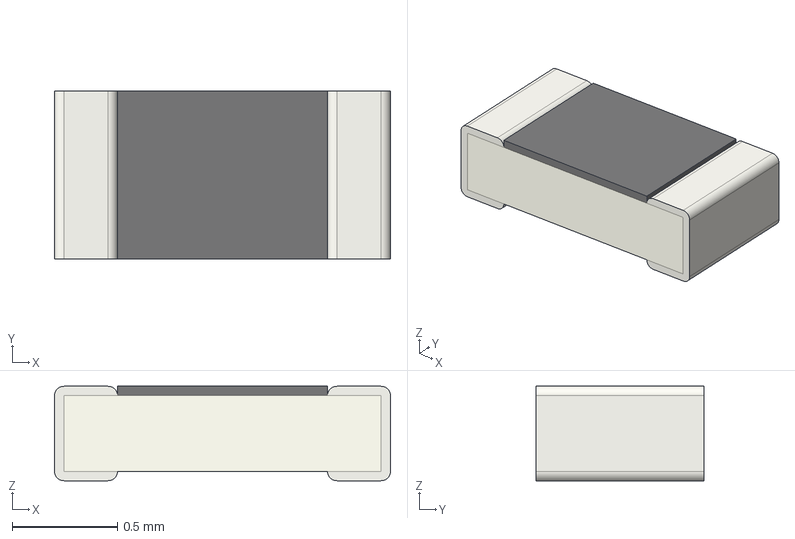
[picture p24: CAD file, 2023-04-08]
Hardware/circuit board design v2.1/Component_3d_models/R_0603_1608Metric.step
1.60 x 0.8 x 0.45 mm
