ImperialSpaceSociety/Flight-Computer/Hardware/circuit board design v2.1/Component_3d_models/DFLT27A-7.stp

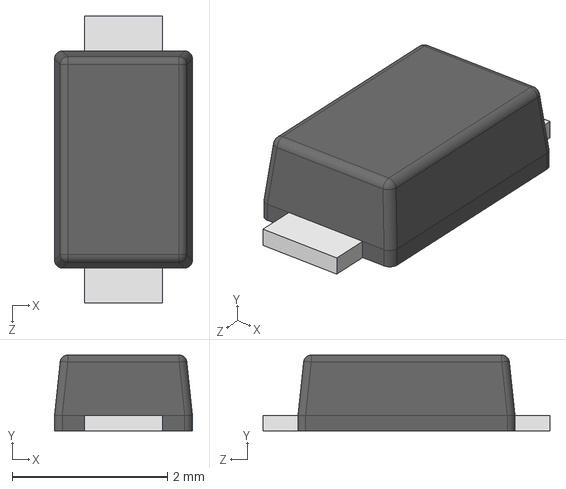
[picture p25: CAD file, 2023-04-08]
Hardware/circuit board design v2.1/Component_3d_models/DFLT27A-7.stp
1.78 x 0.98 x 3.70 mm
