ImperialSpaceSociety/Flight-Computer/Hardware/circuit board design v2.1/Component_3d_models/JST_PH_B4B-PH-K_1x04_P2.00mm_Vertical.step

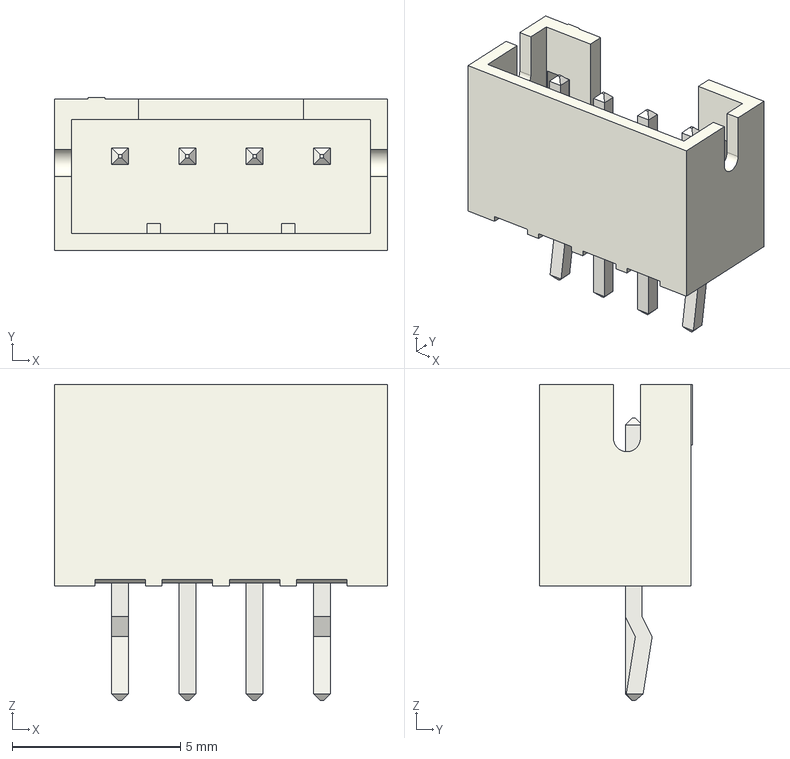
[picture p26: CAD file, 2023-04-08]
Hardware/circuit board design v2.1/Component_3d_models/JST_PH_B4B-PH-K_1x04_P2.00mm_Vertical.step
9.90 x 4.55 x 9.40 mm
