ImperialSpaceSociety/Flight-Computer/Hardware/circuit board design v2.1/Component_3d_models/2N7002-7-F.stp

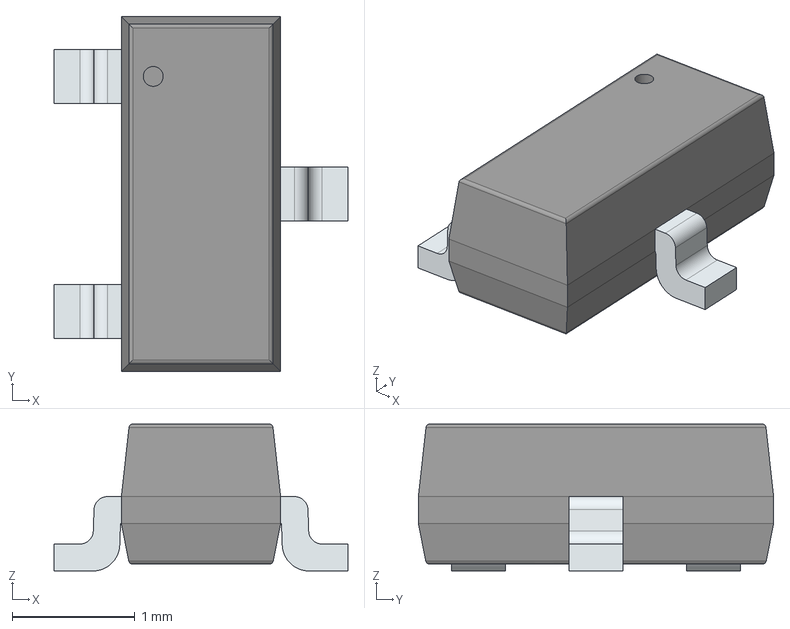
[picture p27: CAD file, 2023-04-08]
Hardware/circuit board design v2.1/Component_3d_models/2N7002-7-F.stp
2.40 x 2.90 x 1.20 mm
PinsArrayL
FilletPinR
