ImperialSpaceSociety/Flight-Computer/Hardware/circuit board design v2.1/Component_3d_models/PinHeader_2x03_P2.54mm_Vertical.step

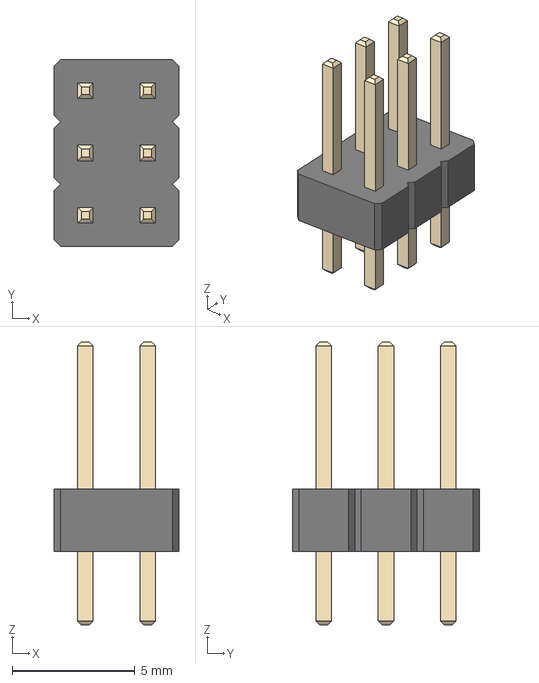
[picture p28: CAD file, 2023-04-08]
Hardware/circuit board design v2.1/Component_3d_models/PinHeader_2x03_P2.54mm_Vertical.step
5.08 x 7.62 x 11.5 mm
