ImperialSpaceSociety/Flight-Computer/Hardware/circuit board design v2.1/Component_3d_models/BMI088.stp

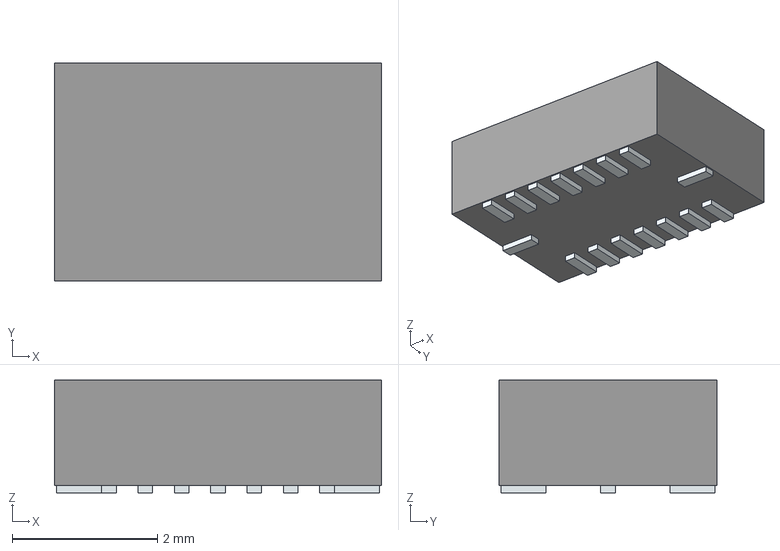
[picture p29: CAD file, 2023-04-08]
Hardware/circuit board design v2.1/Component_3d_models/BMI088.stp
4.50 x 3.00 x 1.55 mm
Pins
