ImperialSpaceSociety/Flight-Computer/Hardware/circuit board design v2.1/Component_3d_models/ECS-80-8-33Q-ADS-TR3.stp

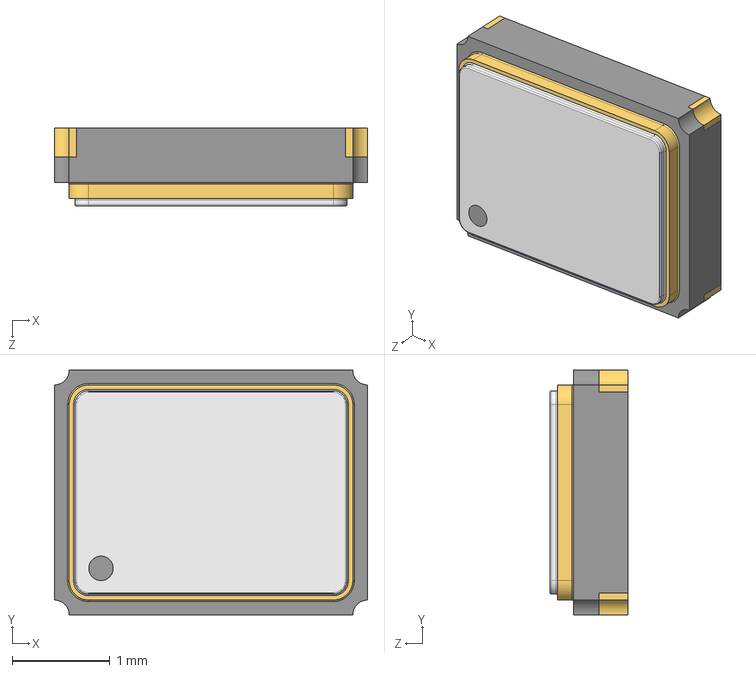
[picture p30: CAD file, 2023-04-08]
Hardware/circuit board design v2.1/Component_3d_models/ECS-80-8-33Q-ADS-TR3.stp
3.20 x 2.50 x 0.8 mm
