ImperialSpaceSociety/Flight-Computer/Hardware/circuit board design v2.1/Component_3d_models/L80-R--3DModel-STEP-56544.STEP

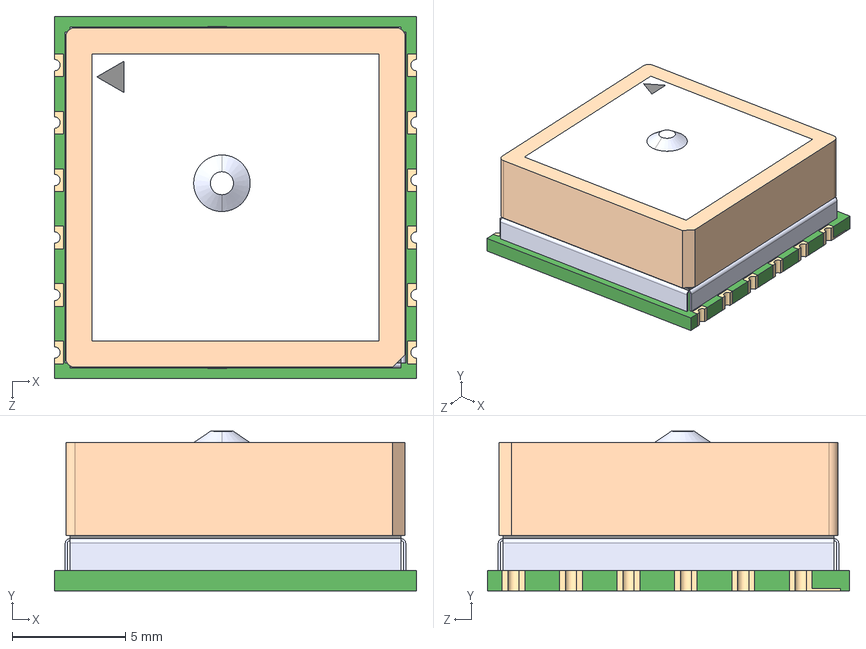
[picture p31: CAD file, 2023-04-01]
Hardware/circuit board design v2.1/Component_3d_models/L80-R--3DModel-STEP-56544.STEP
16.0 x 7.05 x 16.0 mm
