ImperialSpaceSociety/Flight-Computer/(list of files, cad)

Other CAD files:
Hardware/circuit board design v2.1/Component_3d_models/105017-0001.stp
Hardware/circuit board design v2.1/Component_3d_models/SDR08540M3-01.stp
Hardware/enclosure/Electronics+Bay+V2+PCB.f3z
Rocket/Centering ring v4.f3d
Rocket/Centering ring with motor hook slots v8.f3d
Rocket/Cesaroni 29Pro 2G casing v3.f3d
Rocket/Cesaroni 29Pro 2G regular closure v3.f3d
Rocket/Electronics Bay V2 PCB v11 v1.f3d
Rocket/Engine Block Layer Plywood v4.f3d
Rocket/Motor Hook v8.f3d
Rocket/Motor Tube regular v3.f3z
Rocket/Motor mount tube v8.f3d
Rocket/Nose Cone v7.f3d
Rocket/Rail Guide (modified) v2.f3d
Rocket/coupler (4.3mm gap) v5.f3d
