ImperialSpaceSociety/Flight-Computer/Hardware/circuit board design v2.1/plots/circuit board design v2.1__Assembly.pdf

J3 | U3 | R⁹ D⁴ | D3 C⁷ R⁶ C15 D2
SWCLK SWDIO R⁷ U11U7 | U12 | C1 Y¹ | C²

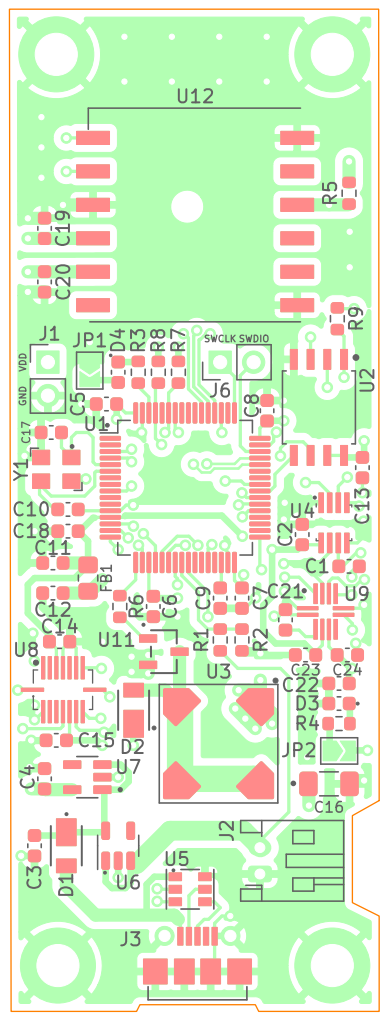
[picture p37: page 1]

File: circuit board design v2.1.kicad_pcb Sheet: Colored-TOP

File: circuit board design v2.1.kicad_pcb Sheet: Colored-BOT | JLCJLCJLCJLC
Timothy Newman Václav Pavlícek | U10C27 J4

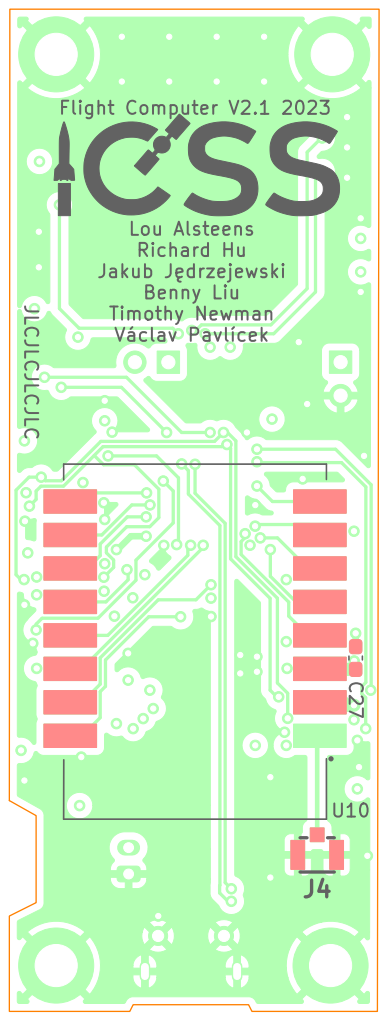
[picture p38: page 2]
D Date: KiCad E.D.A. kicad (6.0.8) Size: A4; Rev:; Id: 1/1 Title:

Flight Computer V2.1 2023 Lou Alsteens Richard Hu

þÿJakub Jdrzejewski Benny Liu

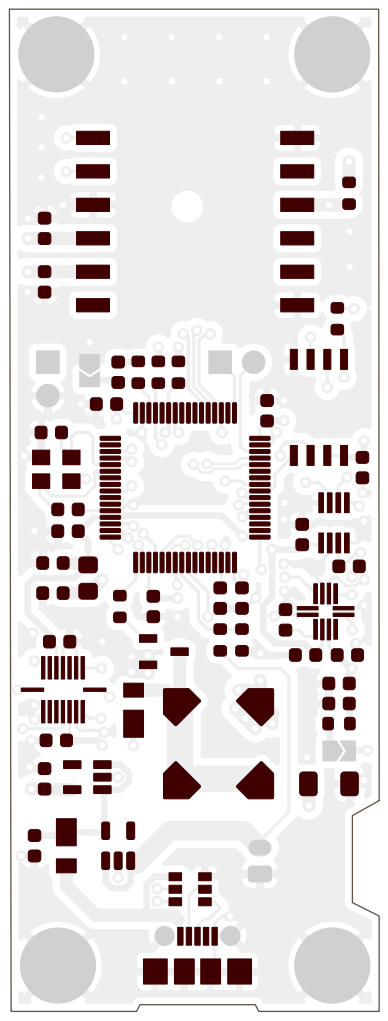
[picture p39: page 3]
D Date: KiCad E.D.A. kicad (6.0.8) Size: A4; Rev:

Sheet: Light-Colors-PCB-Paste-TOP
File: circuit board design v2.1.kicad_pcb
Id: 1/1 Title:
