ImperialSpaceSociety/Flight-Computer/Hardware/circuit board design v1.0/circuit board design v1.0.pdf

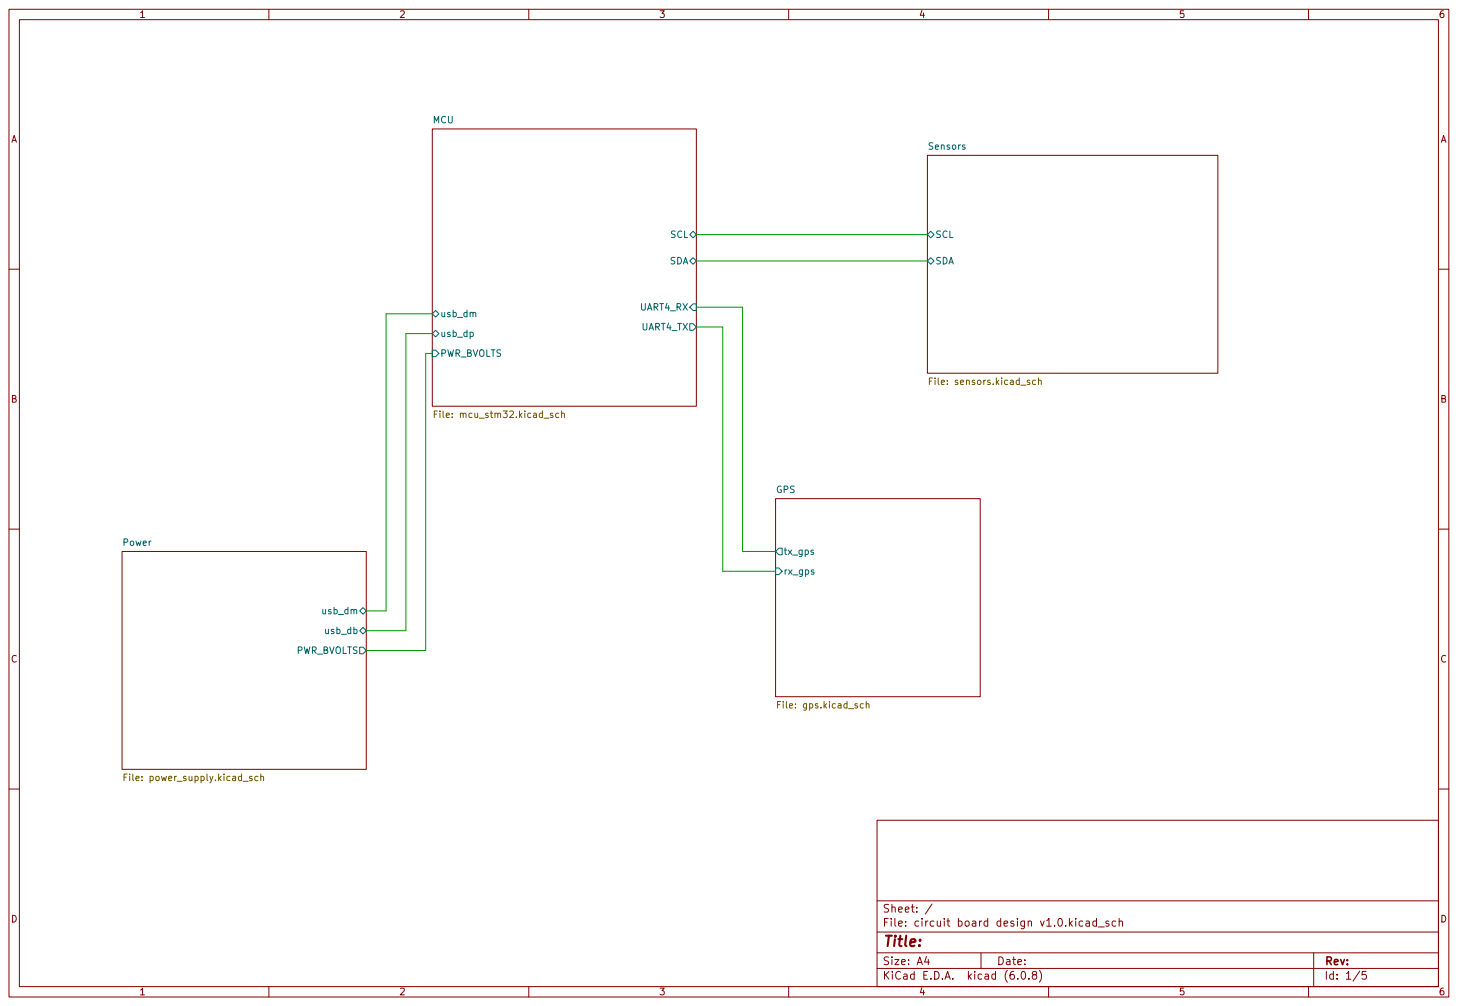
[picture p40: page 1]

File: circuit board design v1.0.kicad_sch Sheet: /
Id: 1/5 Title:

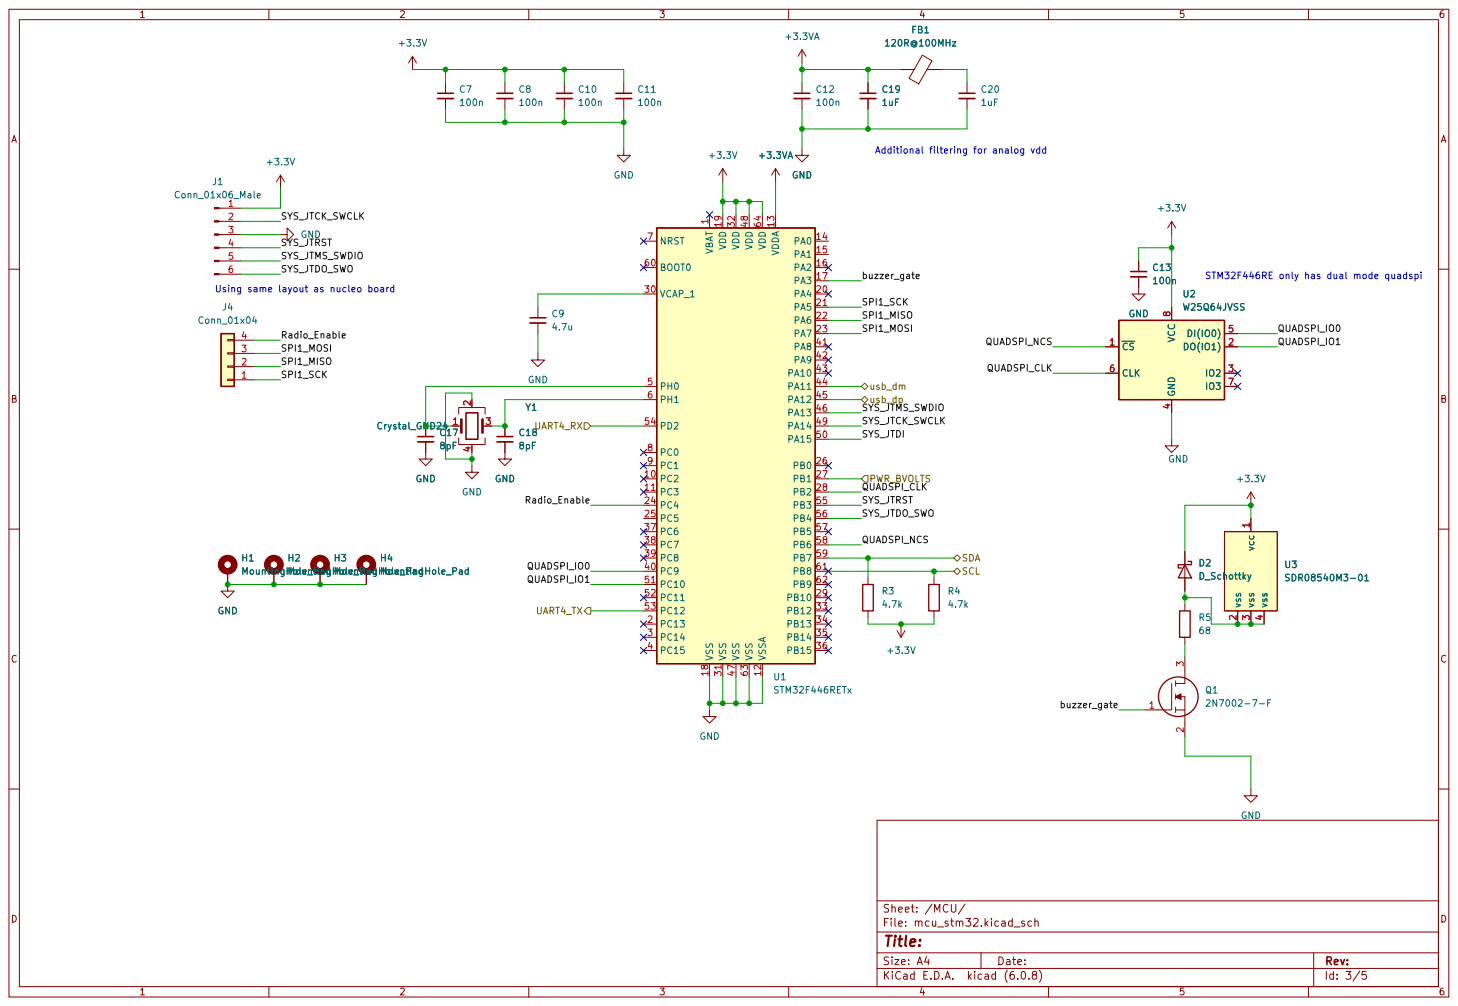
[picture p41: page 2]

Additional filtering for analog vdd H1MountingHole_Pad GND

1 PC2 10 PC3 11 VSSA 12 VDDA 13 PA0 14 PA1 15 PA2 16 PA3 17 VSS 18 VDD 19 PC13 2 PA4 20 PA5 21 PA6 22 PA7 23 PC4 24 PC5 25 PB0 26 PB1 27 PB2 28 PB10 29 PC14 3 VCAP_1 30 VSS 31 VDD 32 PB12 33 PB13 34 PB14 35 PB15 36 PC6 37 PC7 38 PC8 39 PC15 4 PC9 40 PA8 41 PA9 42 PA10 43 PA11 44 PA12 45 PA13 46 VSS 47 VDD 48 PA14 49 PH0 5 PA15 50 PC10 51 PC11 52 PC12 53 PD2 54 PB3 55 PB4 56 PB5 57 PB6 58 PB7 59 PH1 6 BOOT0 60 PB8 61 PB9 62 VSS 63 VDD 64 NRST 7 PC0 8 PC1 9 U1STM32F446RETx

STM32F446RE only has dual mode quadspi

8 U3SDR08540M3-01 vcc 1 vss 2 vss 3 vss 4 D2D_Schottky H3MountingHole_Pad H2MountingHole_Pad H4MountingHole_Pad C18

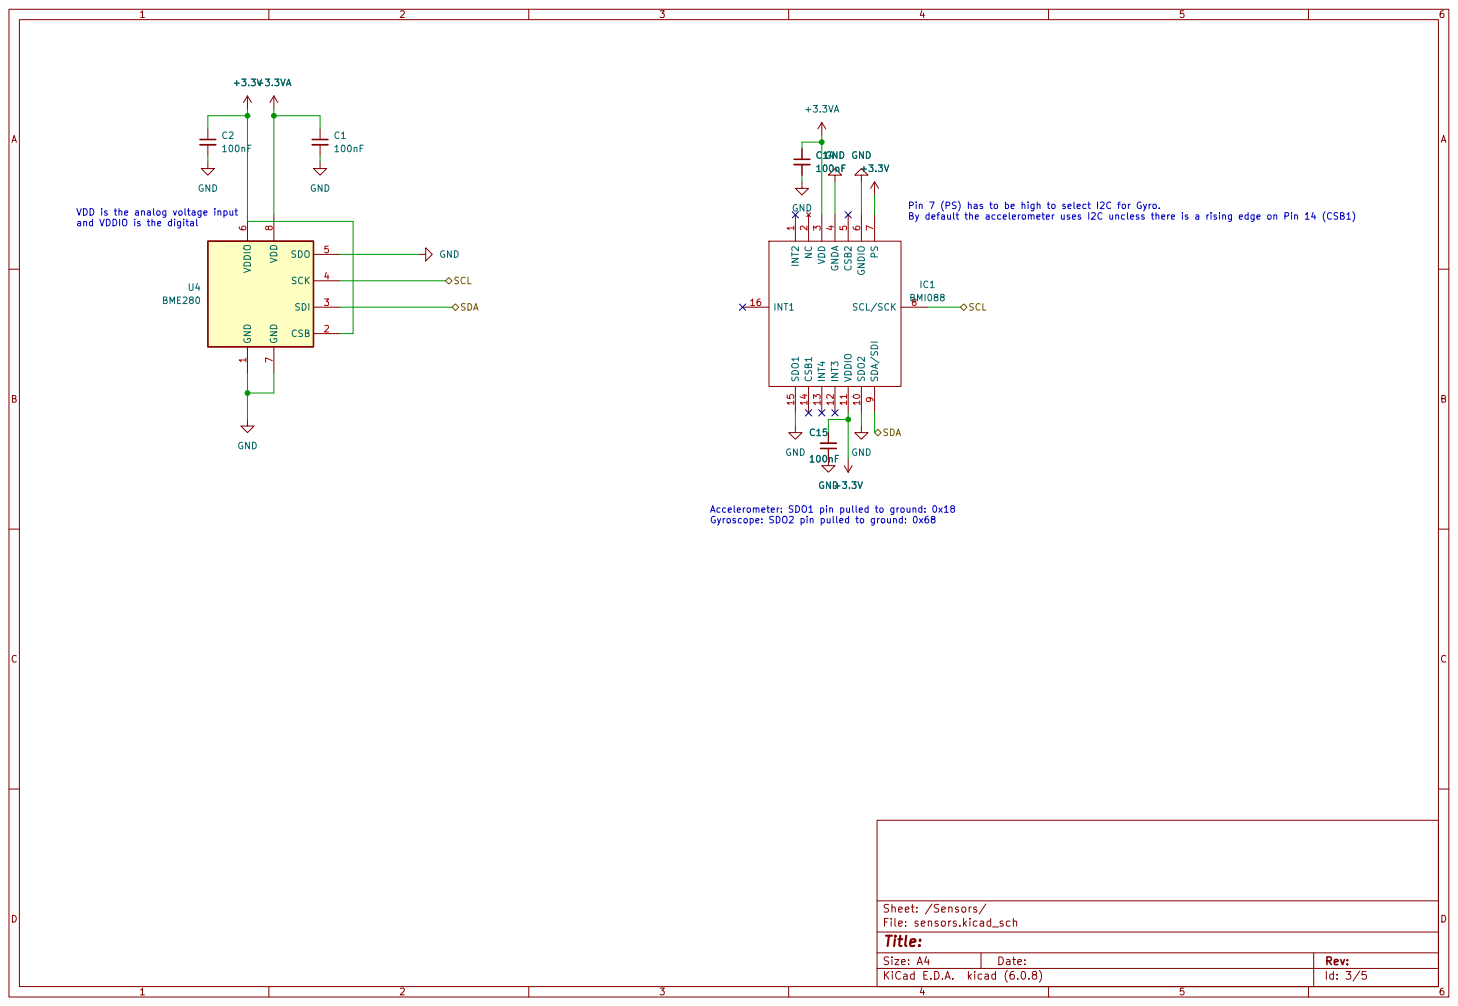
[picture p42: page 3]

VDD is the analog voltage input
and VDDIO is the digital

By default the accelerometer uses I2C uncless there is a rising edge on Pin 14 (CSB1) +3.3V C15

Pin 7 (PS) has to be high to select I2C for Gyro.

7 SCL/SCK 8 SDA/SDI 9

1 CSB 2 SDI 3 SCK 4 SDO 5 VDDIO

Accelerometer: SDO1 pin pulled to ground: 0x18
Gyroscope: SDO2 pin pulled to ground: 0x68

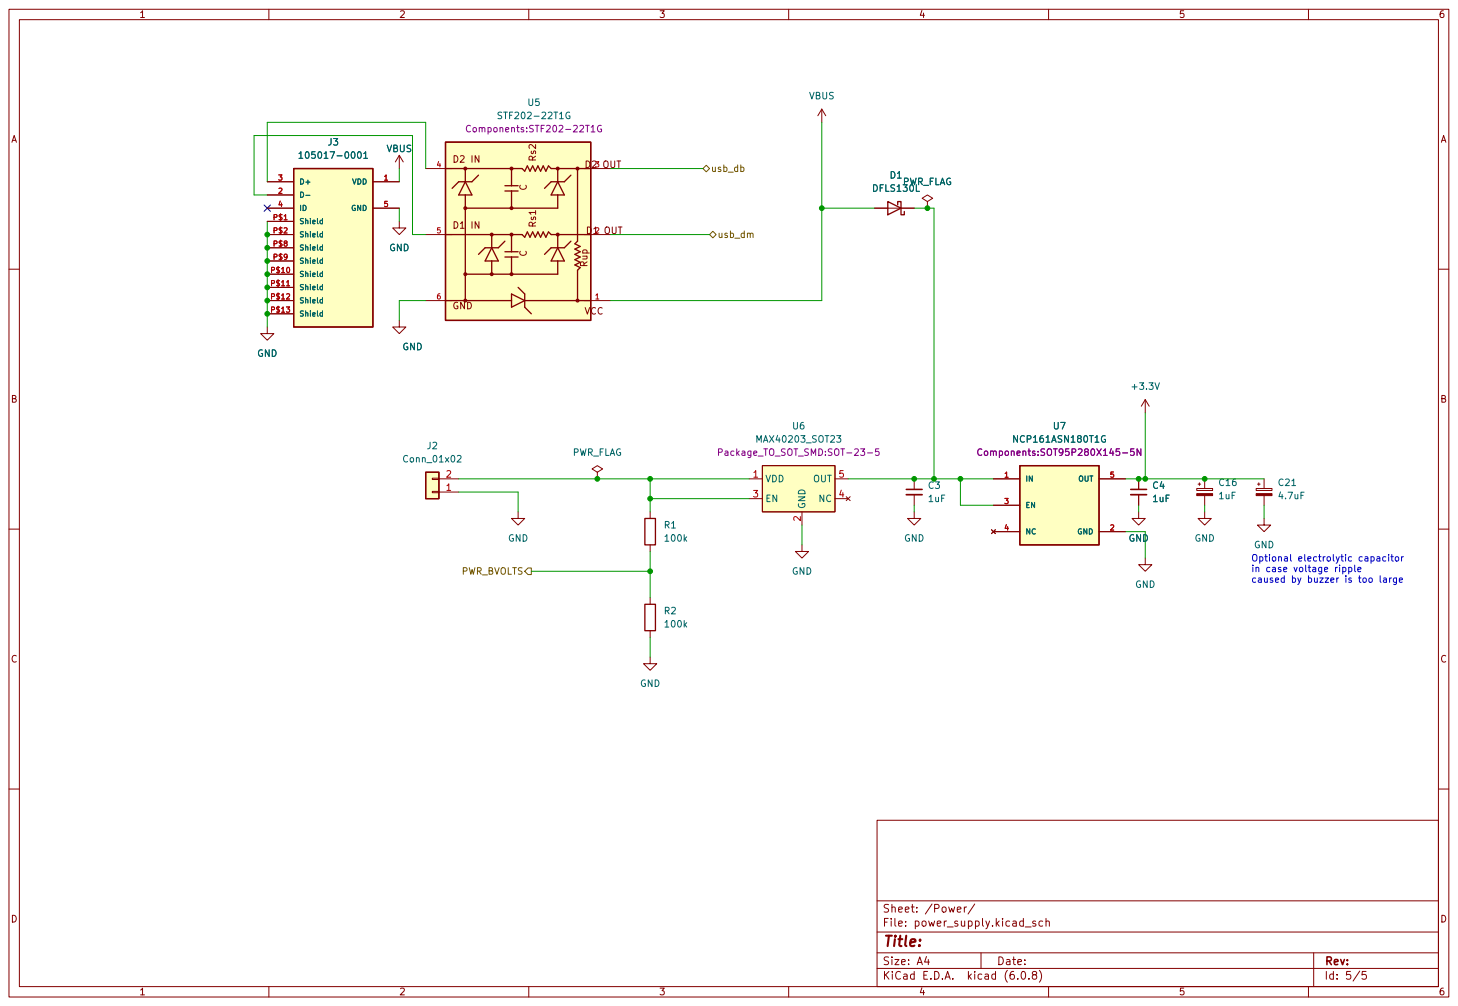
[picture p43: page 4]

caused by buzzer is too large D1 DFLS130L PWR_FLAG

2 EN 3 NC 4 OUT 5 U6 MAX40203_SOT23 Package_TO_SOT_SMD:SOT-23-5

in case voltage ripple

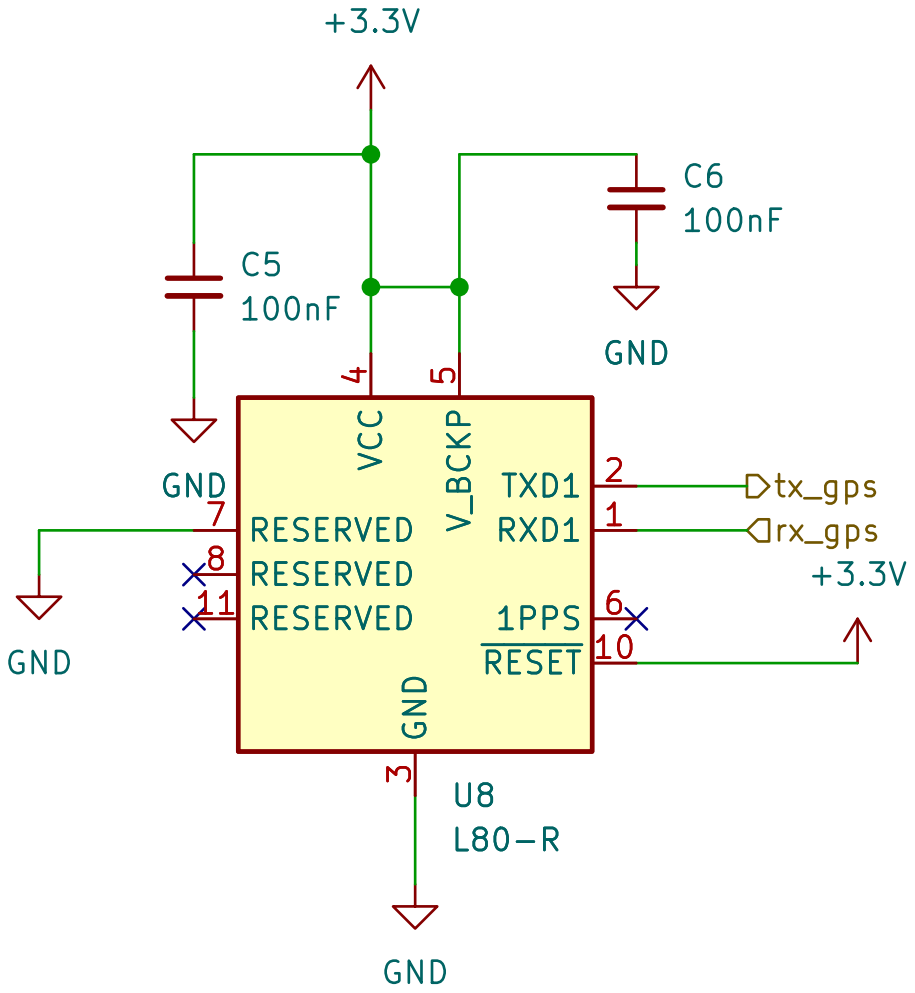
[picture p44: page 5]

File: gps.kicad_sch Sheet: /GPS/
Id: 5/5 Title:
