ImperialSpaceSociety/Flight-Computer/Hardware/circuit board design v2.1/circuit board design v2.1.kicad_pcb

## KiCad design Hardware/circuit board design v2.1/circuit board design v2.1.kicad_pcb (2023-06-03)

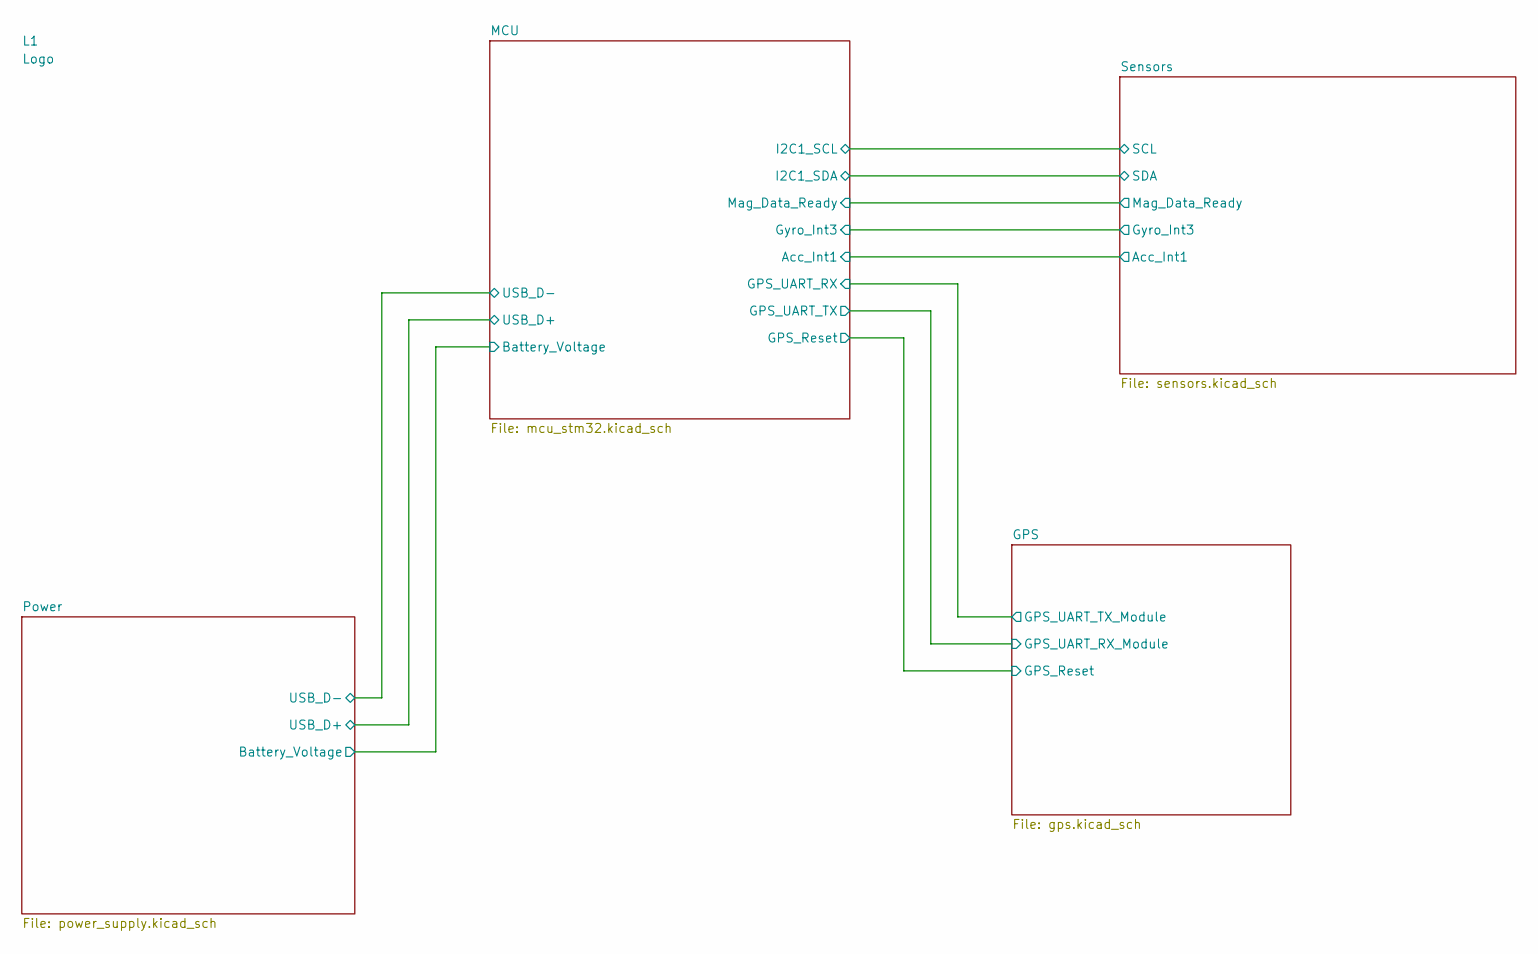
[picture p45: schematic circuit board design v2.1.kicad_sch]

Parts:
L1: Logo; ICSS_Logo

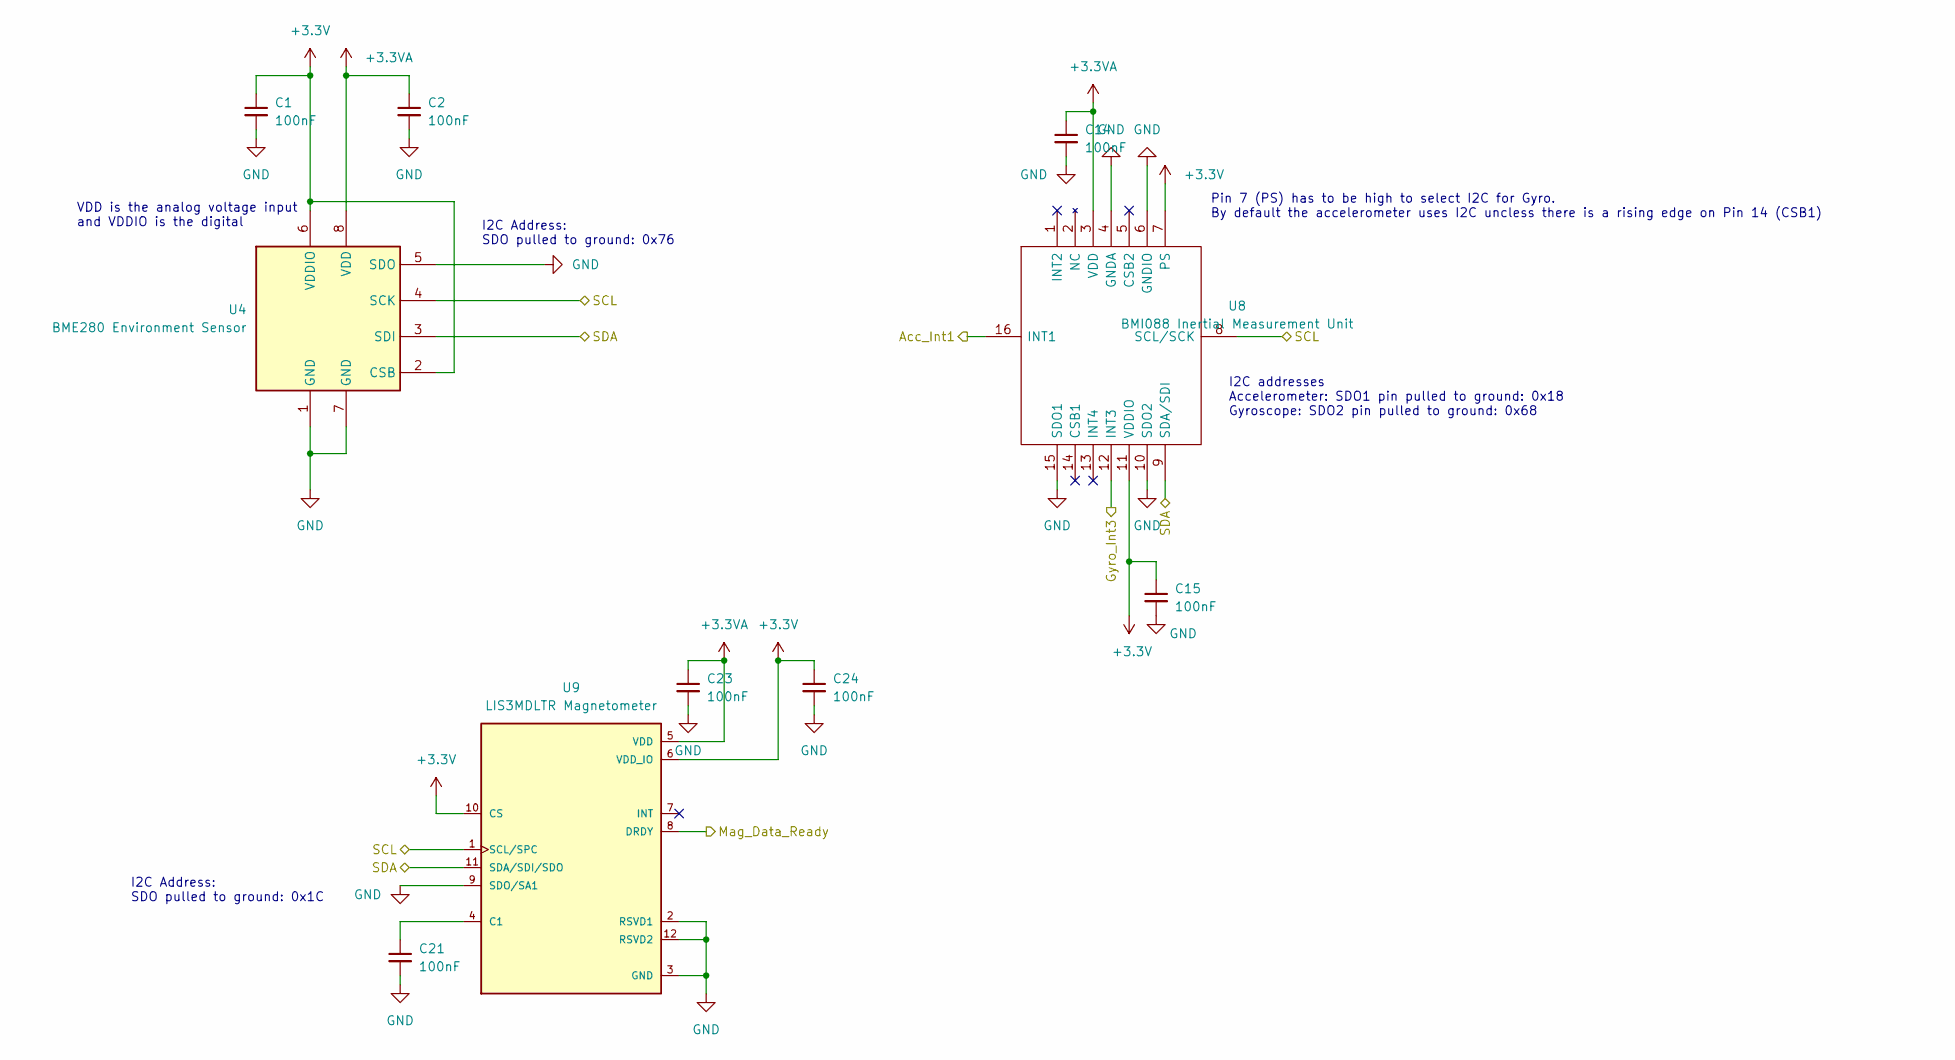
[picture p46: schematic sensors.kicad_sch]

Parts:
C1, C2, C14, C15, C21, C23, C24: 100nF; C_0603_1608Metric
U4: BME280 Environment Sensor; Bosch_LGA-8_2.5x2.5mm_P0.65mm_ClockwisePinNumbering
U8: BMI088 Inertial Measurement Unit; BMI088; Manufacturer_Part_Number BMI088; Mouser Part Number 262-BMI088
U9: LIS3MDLTR Magnetometer; XDCR_LIS3MDLTR; PARTREV 6

Connections:
+3.3V: C1.1, C15.1, C24.1, U4.2 (CSB), U4.6 (VDDIO), U8.7 (PS), U8.11 (VDDIO), U9.6 (VDD_IO), U9.10 (CS); also elsewhere on the board
+3.3VA: C2.1, C14.1, C23.1, U4.8 (VDD), U8.3 (VDD), U9.5 (VDD); also elsewhere on the board
/MCU/Acc_Int1: U8.16 (INT1); also elsewhere on the board
/MCU/Gyro_Int3: U8.12 (INT3); also elsewhere on the board
/MCU/I2C1_SCL: U4.4 (SCK), U8.8 (SCL/SCK), U9.1 (SCL/SPC); also elsewhere on the board
/MCU/I2C1_SDA: U4.3 (SDI), U8.9 (SDA/SDI), U9.11 (SDA/SDI/SDO); also elsewhere on the board
/MCU/Mag_Data_Ready: U9.8 (DRDY); also elsewhere on the board
GND: C1.2, C2.2, C14.2, C15.2, C21.2, C23.2, C24.2, U4.1 (GND), U4.5 (SDO), U4.7 (GND), U8.4 (GNDA), U8.6 (GNDIO), U8.10 (SDO2), U8.15 (SDO1), U9.2 (RSVD1), U9.3 (GND), U9.9 (SDO/SA1), U9.12 (RSVD2); also elsewhere on the board
unnamed: C21.1, U9.4 (C1)

Notes on the sheet:
VDD is the analog voltage input and VDDIO is the digital
Pin 7 (PS) has to be high to select I2C for Gyro. By default the accelerometer uses I2C uncless there is a rising edge on Pin 14 (CSB1)
I2C addresses Accelerometer: SDO1 pin pulled to ground: 0x18 Gyroscope: SDO2 pin pulled to ground: 0x68
I2C Address: SDO pulled to ground: 0x1C
I2C Address: SDO pulled to ground: 0x76

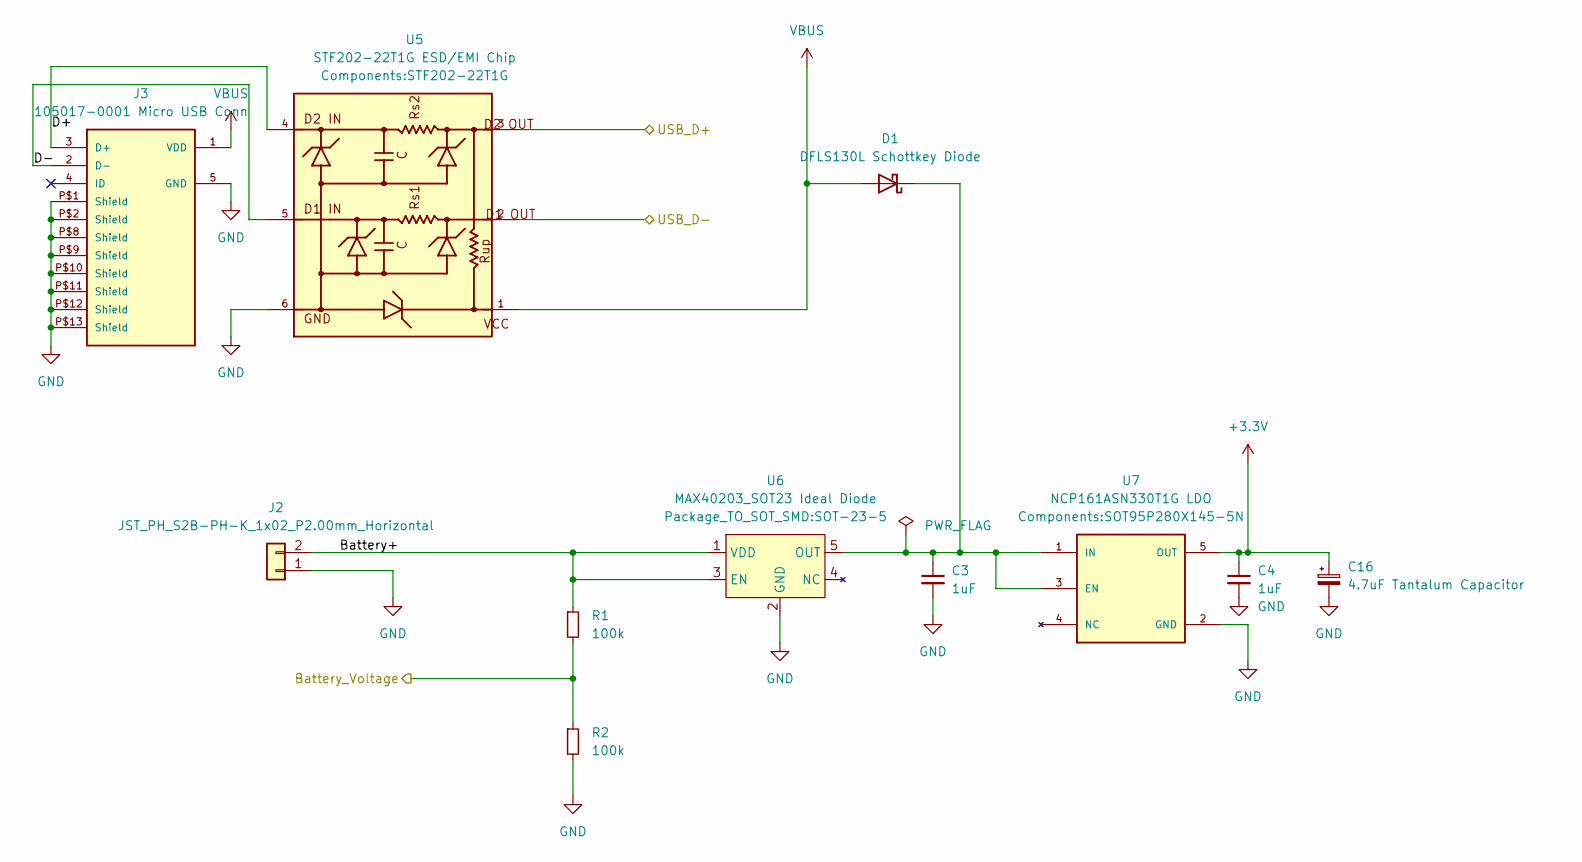
[picture p47: schematic power_supply.kicad_sch]

Parts:
C3, C4: 1uF; C_0603_1608Metric
C16: 4.7uF Tantalum Capacitor; C_1206_3216Metric_Pad1.33x1.80mm_HandSolder
D1: DFLS130L Schottkey Diode; PowerDI123
J2: JST_PH_S2B-PH-K_1x02_P2.00mm_Horizontal
J3: 105017-0001 Micro USB Conn; MOLEX_105017-0001
R1, R2: 100k; R_0603_1608Metric
U5: STF202-22T1G ESD/EMI Chip; STF202-22T1G
U6: MAX40203_SOT23 Ideal Diode; SOT-23-5
U7: NCP161ASN330T1G LDO; SOT95P280X145-5N; PARTREV Rev. 18

Connections:
+3.3V: C4.1, C16.1, U7.5 (OUT); also elsewhere on the board
/MCU/Battery_Voltage: R1.2, R2.1; also elsewhere on the board
/MCU/USB_D+: U5.3; also elsewhere on the board
/MCU/USB_D-: U5.2; also elsewhere on the board
/Power/Battery+: J2.2, R1.1, U6.1 (VDD), U6.3 (EN)
/Power/D+: J3.3 (D+), U5.4
/Power/D-: J3.2 (D-), U5.5
GND: C3.2, C4.2, C16.2, J2.1, J3.5 (GND), J3.P$1 (Shield), J3.P$2 (Shield), J3.P$8 (Shield), J3.P$9 (Shield), J3.P$10 (Shield), J3.P$11 (Shield), J3.P$12 (Shield), J3.P$13 (Shield), R2.2, U5.6, U6.2 (GND), U7.2 (GND); also elsewhere on the board
unnamed: C3.1, D1.1 (K), U6.5 (OUT), U7.1 (IN), U7.3 (EN)
VBUS: D1.2 (A), J3.1 (VDD), U5.1

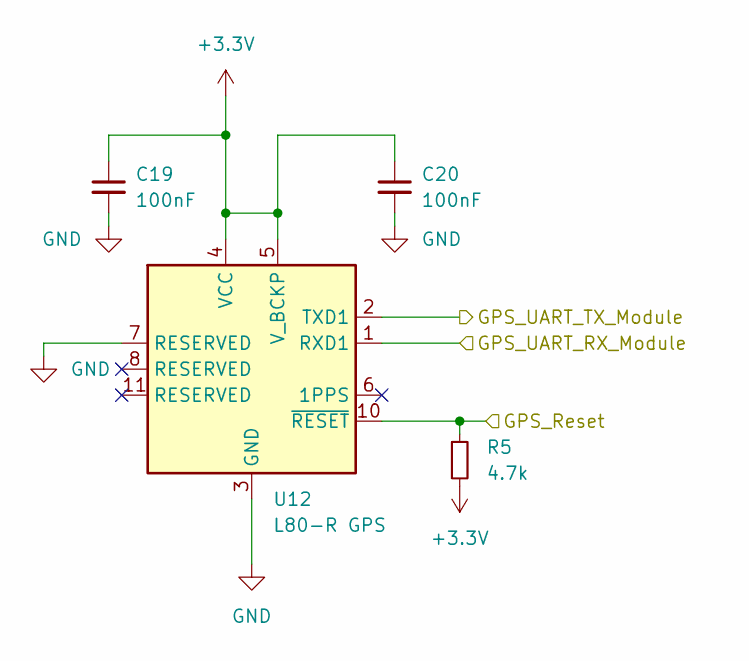
[picture p48: schematic gps.kicad_sch]

Parts:
C19, C20: 100nF; C_0603_1608Metric
R5: 4.7k; R_0603_1608Metric
U12: L80-R GPS; Quectel_L80-R

Connections:
+3.3V: C19.1, C20.1, R5.2, U12.4 (VCC), U12.5 (V_BCKP); also elsewhere on the board
/GPS/GPS_Reset: R5.1, U12.10 (~RESET); also elsewhere on the board
/GPS/GPS_UART_RX_Module: U12.1 (RXD1); also elsewhere on the board
/GPS/GPS_UART_TX_Module: U12.2 (TXD1); also elsewhere on the board
GND: C19.2, C20.2, U12.3 (GND), U12.7 (RESERVED), U12.12 (GND); also elsewhere on the board

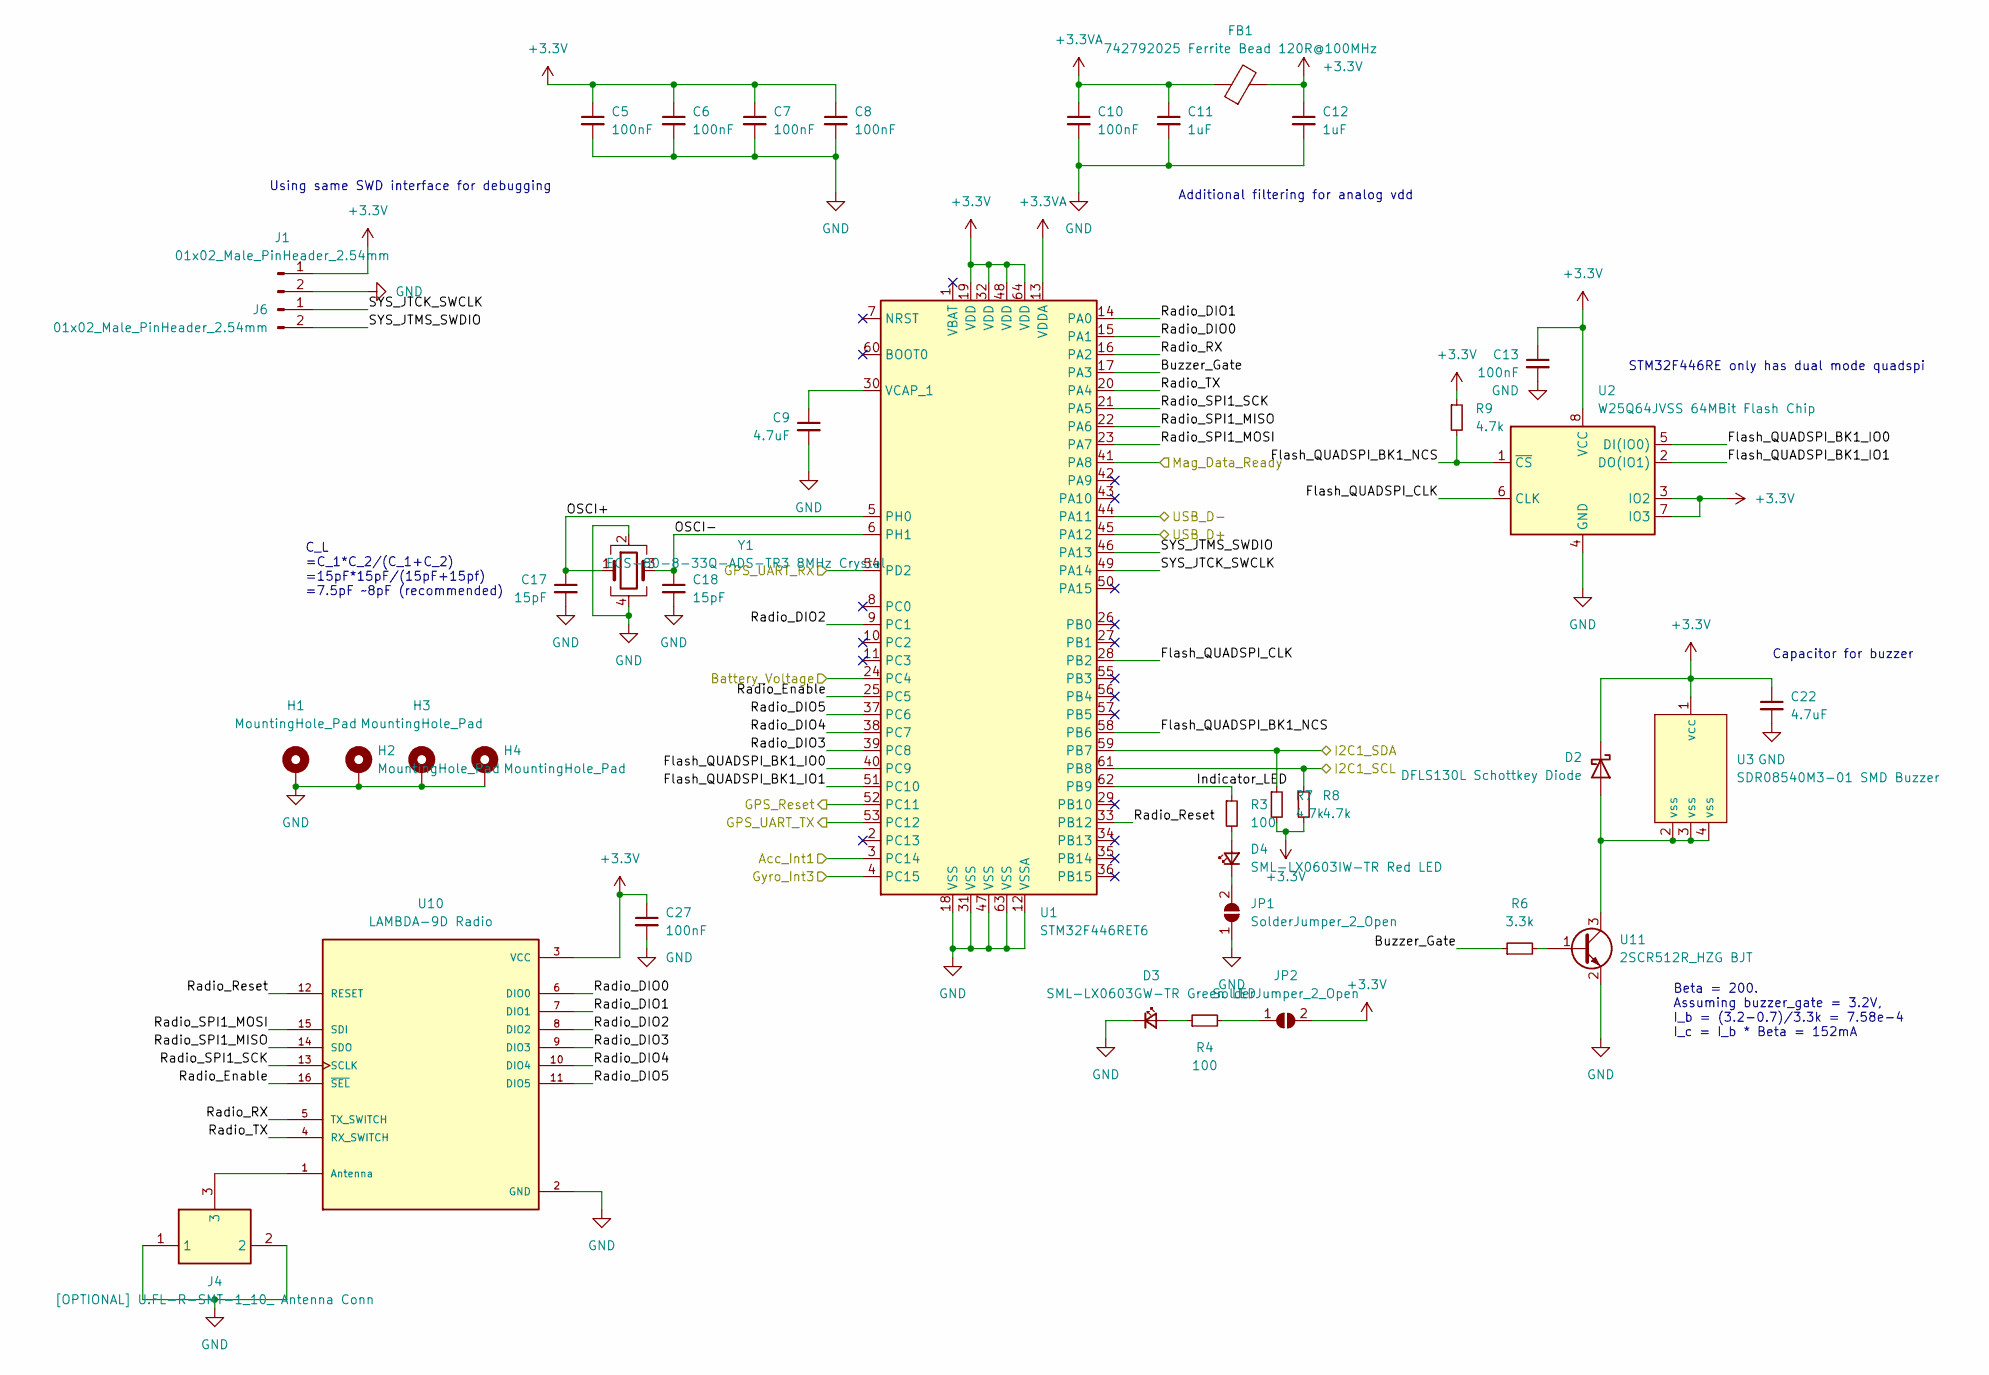
[picture p49: schematic mcu_stm32.kicad_sch]

Parts:
C5, C6, C7, C8, C10, C13: 100nF; C_0603_1608Metric
C9, C22: 4.7uF; C_0603_1608Metric
C11, C12: 1uF; C_0603_1608Metric
C17, C18: 15pF; C_0603_1608Metric
C27: 100nF; C_0603_1608Metric_Pad1.08x0.95mm_HandSolder
D2: DFLS130L Schottkey Diode; PowerDI123
D3: SML-LX0603GW-TR Green LED; C_0603_1608Metric
D4: SML-LX0603IW-TR Red LED; C_0603_1608Metric
FB1: 742792025 Ferrite Bead 120R@100MHz; R_0805_2012Metric_Pad1.20x1.40mm_HandSolder
H1, H2, H3, H4: MountingHole_Pad; MountingHole_3.2mm_M3_ISO7380_Pad_TopBottom
J1, J6: 01x02_Male_PinHeader_2.54mm; PinHeader_1x02_P2.54mm_Vertical
J4: [OPTIONAL] U.FL-R-SMT-1_10_ Antenna Conn; U.FL-R-SMT-1_10_; Manufacturer_Part_Number U.FL-R-SMT-1(10); Mouser Part Number 798-U.FL-R-SMT-110
JP1, JP2: SolderJumper_2_Open; SolderJumper-2_P1.3mm_Open_TrianglePad1.0x1.5mm
R3, R4: 100; R_0603_1608Metric
R6: 3.3k; R_0603_1608Metric
R7, R8, R9: 4.7k; R_0603_1608Metric
U1: STM32F446RET6; LQFP-64_10x10mm_P0.5mm
U2: W25Q64JVSS 64MBit Flash Chip; W25Q64JVSSIQ
U3: SDR08540M3-01 SMD Buzzer; SDR08540M3-01 Buzzer
U10: LAMBDA-9D Radio; XCVR_LAMBDA-9D; PARTREV N/A
U11: 2SCR512R_HZG BJT; 2SCR512RHZG
Y1: ECS-80-8-33Q-ADS-TR3 8MHz Crystal; ECS-80-8-33Q-ADS-TR3 Crystal

Connections:
+3.3V: C5.1, C6.1, C7.1, C8.1, C12.1, C13.1, C22.1, C27.1, D2.1 (K), FB1.2, J1.1, JP2.2 (B), R7.2, R8.2, R9.1, U1.19 (VDD), U1.32 (VDD), U1.48 (VDD), U1.64 (VDD), U2.3 (IO2), U2.7 (IO3), U2.8 (VCC), U3.1 (vcc), U10.3 (VCC); also elsewhere on the board
+3.3VA: C10.1, C11.1, FB1.1, U1.13 (VDDA); also elsewhere on the board
/GPS/GPS_Reset: U1.52 (PC11); also elsewhere on the board
/GPS/GPS_UART_RX_Module: U1.53 (PC12); also elsewhere on the board
/GPS/GPS_UART_TX_Module: U1.54 (PD2); also elsewhere on the board
/MCU/Acc_Int1: U1.3 (PC14); also elsewhere on the board
/MCU/Battery_Voltage: U1.24 (PC4); also elsewhere on the board
/MCU/Buzzer_Gate: R6.1, U1.17 (PA3)
/MCU/Flash_QUADSPI_BK1_IO0: U1.40 (PC9), U2.5 (DI(IO0))
/MCU/Flash_QUADSPI_BK1_IO1: U1.51 (PC10), U2.2 (DO(IO1))
/MCU/Flash_QUADSPI_BK1_NCS: R9.2, U1.58 (PB6), U2.1 (~CS)
/MCU/Flash_QUADSPI_CLK: U1.28 (PB2), U2.6 (CLK)
/MCU/Gyro_Int3: U1.4 (PC15); also elsewhere on the board
/MCU/I2C1_SCL: R8.1, U1.61 (PB8); also elsewhere on the board
/MCU/I2C1_SDA: R7.1, U1.59 (PB7); also elsewhere on the board
/MCU/Indicator_LED: R3.1, U1.62 (PB9)
/MCU/Mag_Data_Ready: U1.41 (PA8); also elsewhere on the board
/MCU/OSCI+: C17.1, U1.5 (PH0), Y1.1
/MCU/OSCI-: C18.1, U1.6 (PH1), Y1.3
/MCU/Radio_DIO0: U1.15 (PA1), U10.6 (DIO0)
/MCU/Radio_DIO1: U1.14 (PA0), U10.7 (DIO1)
/MCU/Radio_DIO2: U1.9 (PC1), U10.8 (DIO2)
/MCU/Radio_DIO3: U1.39 (PC8), U10.9 (DIO3)
/MCU/Radio_DIO4: U1.38 (PC7), U10.10 (DIO4)
/MCU/Radio_DIO5: U1.37 (PC6), U10.11 (DIO5)
/MCU/Radio_Enable: U1.25 (PC5), U10.16 (~SEL)
/MCU/Radio_RX: U1.16 (PA2), U10.5 (TX_SWITCH)
/MCU/Radio_Reset: U1.33 (PB12), U10.12 (RESET)
/MCU/Radio_SPI1_MISO: U1.22 (PA6), U10.14 (SDO)
/MCU/Radio_SPI1_MOSI: U1.23 (PA7), U10.15 (SDI)
/MCU/Radio_SPI1_SCK: U1.21 (PA5), U10.13 (SCLK)
/MCU/Radio_TX: U1.20 (PA4), U10.4 (RX_SWITCH)
/MCU/SYS_JTCK_SWCLK: J6.1, U1.49 (PA14)
/MCU/SYS_JTMS_SWDIO: J6.2, U1.46 (PA13)
/MCU/USB_D+: U1.45 (PA12); also elsewhere on the board
/MCU/USB_D-: U1.44 (PA11); also elsewhere on the board
GND: C5.2, C6.2, C7.2, C8.2, C9.2, C10.2, C11.2, C12.2, C13.2, C17.2, C18.2, C22.2, C27.2, D3.1 (K), H1.1, H2.1, H3.1, H4.1, J1.2, J4.1, J4.2, JP1.1 (A), U1.12 (VSSA), U1.18 (VSS), U1.31 (VSS), U1.47 (VSS), U1.63 (VSS), U2.4 (GND), U10.2 (GND), U11.2 (E), Y1.2, Y1.4; also elsewhere on the board
unnamed: C9.1, U1.30 (VCAP_1)
unnamed: D2.2 (A), U3.2 (vss), U3.3 (vss), U3.4 (vss), U11.3 (C)
unnamed: D3.2 (A), R4.1
unnamed: D4.1 (K), JP1.2 (B)
unnamed: D4.2 (A), R3.2
unnamed: J4.3, U10.1 (Antenna)
unnamed: JP2.1 (A), R4.2
unnamed: R6.2, U11.1 (B)

Notes on the sheet:
Capacitor for buzzer
Using same SWD interface for debugging
STM32F446RE only has dual mode quadspi
Additional filtering for analog vdd
C_L =C_1*C_2/(C_1+C_2) =15pF*15pF/(15pF+15pf) =7.5pF ~8pF (recommended)
Beta = 200. Assuming buzzer_gate = 3.2V, I_b = (3.2-0.7)/3.3k = 7.58e-4 I_c = I_b * Beta = 152mA

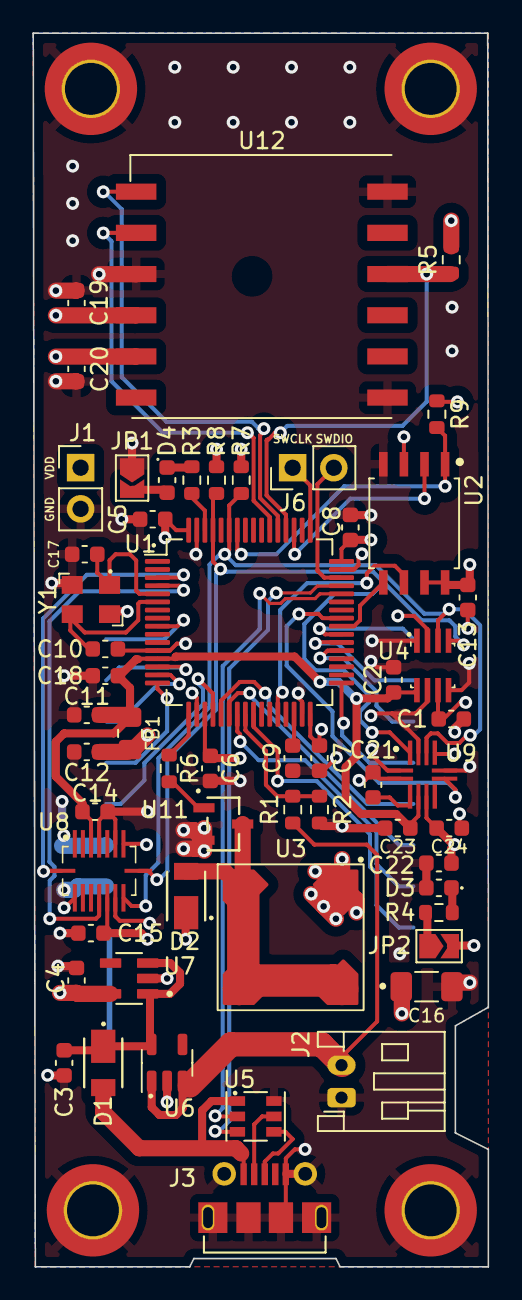
[picture p50: board circuit board design v2.1.kicad_pcb from above]

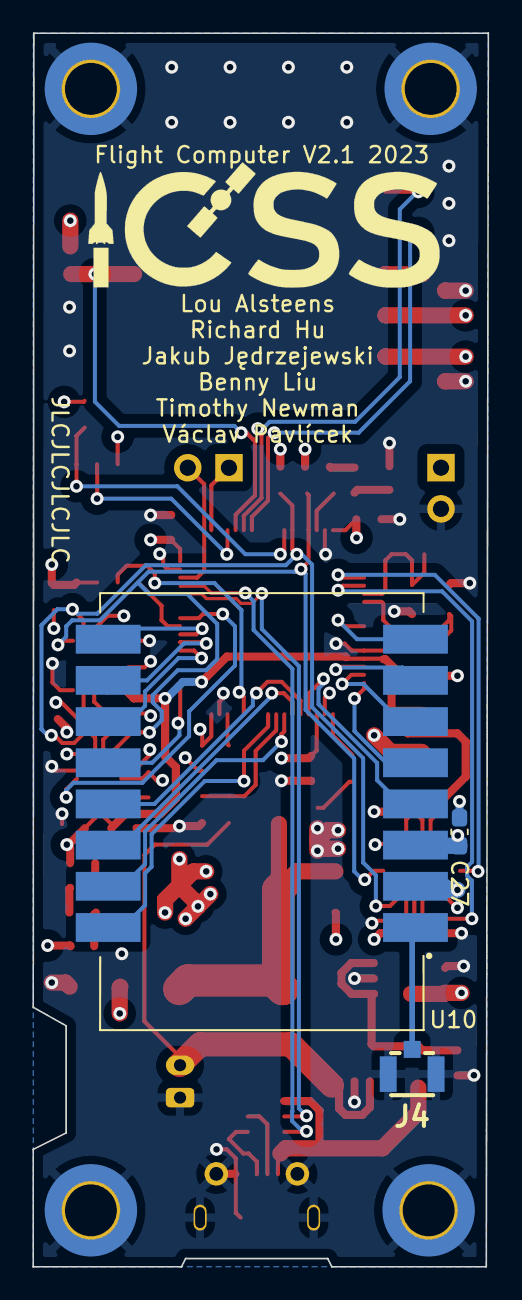
[picture p51: board circuit board design v2.1.kicad_pcb from below]

Board: 4 copper layers, 28.1 x 76.1 mm, 64 parts (4 on the bottom side), 51 nets.
