ImperialSpaceSociety/Flight-Computer/Software/Dev board code/SX1272_tx/Core/Src/main.c

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
/* Includes ------------------------------------------------------------------*/
#include "main.h"

/* USER CODE BEGIN Includes */
#include "sx1272.h"
#include "sx1272_regs.h"
/* USER CODE END Includes */

SPI_HandleTypeDef hspi1;

TIM_HandleTypeDef htim6;

UART_HandleTypeDef huart2;

/* USER CODE BEGIN PV */
int counter = 0;

sx1272_t sx;
sx_gpio_t sx_cs_gpio, sx_tx_gpio, sx_rx_gpio;

int buttonPressed = 0;
uint8_t buf[256] = "Hello, world!";
int mode = 1;


/* USER CODE END PV */

void SystemClock_Config(void);
static void MX_GPIO_Init(void);
static void MX_USART2_UART_Init(void);
static void MX_TIM6_Init(void);
static void MX_SPI1_Init(void);
/* USER CODE BEGIN 0 */
#ifdef __GNUC__
#define PUTCHAR_PROTOTYPE int __io_putchar(int ch)
#else
#define PUTCHAR_PROTOTYPE int fputc(int ch, FILE *f)
#endif

PUTCHAR_PROTOTYPE
{
  HAL_UART_Transmit(&huart2, (uint8_t *)&ch, 1, HAL_MAX_DELAY);
  return ch;
}

void HAL_GPIO_EXTI_Callback(uint16_t pin) {
	if (pin == BTN1_Pin) {
		if (! HAL_GPIO_ReadPin(BTN1_GPIO_Port, BTN1_Pin)) {
			buttonPressed = 1;
		}
	}
}
/* USER CODE END 0 */

/**
  * @brief  The application entry point.
  * @retval int
  */
int main(void)
{
  /* MCU Configuration--------------------------------------------------------*/

  /* Reset of all peripherals, Initializes the Flash interface and the Systick. */
  HAL_Init();

  /* Configure the system clock */
  SystemClock_Config();

  /* Initialize all configured peripherals */
  MX_GPIO_Init();
  MX_USART2_UART_Init();
  MX_TIM6_Init();
  MX_SPI1_Init();
  /* USER CODE BEGIN 2 */
  sx_cs_gpio = (sx_gpio_t) {
  		.port = Radio_Enable_GPIO_Port,
  		.pin = Radio_Enable_Pin,
  	};

  	sx_tx_gpio = (sx_gpio_t) {
  		.port = Radio_TX_GPIO_Port,
  		.pin = Radio_TX_Pin,
  	};

  	sx_rx_gpio = (sx_gpio_t) {
  		.port = Radio_RX_GPIO_Port,
  		.pin = Radio_RX_Pin,
  	};

  	// Init device structure

  	sx = (sx1272_t) {
  			.spi = &hspi1,
  			.cs_gpio = &sx_cs_gpio,
  			.tx_gpio = &sx_tx_gpio,
  			.rx_gpio = &sx_rx_gpio,
  			.packet_length = 16,
  	};

  	/*printf("tx (1), rx (2), tx_no_crc (3), echo_src (4), echo_wall (5) ? ");
  	fflush(stdout);*/

  	mode = 1;//__io_getchar() - '0';

  	printf("\r\nGot mode: %d\r\n", mode);


  	if (sx1272_common_init(&sx, !(mode == 3))) {
  		Error_Handler();
  	}

  	printf("sx1272 init success!\r\n");

  	if (mode == 3) {
  		mode = 1;
  		strcpy((char *)buf, "xxxxx, xxxxx!");
  	}

  /* USER CODE END 2 */

  /* Infinite loop */
  /* USER CODE BEGIN WHILE */
  while (1)
  {
    /* USER CODE END WHILE */

    /* USER CODE BEGIN 3 */
	  /*if (mode == 5) {	// echo_wall
		HAL_GPIO_WritePin(LD2_GPIO_Port, LD2_Pin, 0);
		uint8_t rcv[16];
		int ret = sx1272_receive_continuous(&sx, rcv, true);

		sx1272_transmit(&sx, rcv);
		printf("Echo: %.16s\r\n", rcv);

		HAL_GPIO_WritePin(LD2_GPIO_Port, LD2_Pin, 1);
	}
	else {
		HAL_Delay(50);
	}

	if (buttonPressed) {
		buttonPressed = 0;

		if (mode == 1) {*/
			// TX

			//HAL_GPIO_WritePin(LD2_GPIO_Port, LD2_Pin, 1);

			/*int ret = sx1272_transmit(&sx, buf);

			//HAL_GPIO_WritePin(LD2_GPIO_Port, LD2_Pin, 0);
			printf("Tx status: %d\r\n", ret);*/

	  htim6.Instance->CNT = 0;
			HAL_TIM_Base_Start(&htim6);

			int ret = sx1272_receive_continuous(&sx, buf, true);

			HAL_TIM_Base_Stop(&htim6);

			printf("Time from last RX: %ldms\r\n", htim6.Instance->CNT / 2);

			//HAL_GPIO_WritePin(LD2_GPIO_Port, LD2_Pin, 0);
			printf("RX status: %d\r\n", ret);

			for (int i=0; i<256; i++) {
				if (buf[i] == 0)
					buf[i] = ' ';
			}
			printf("Got: %.256s\r\n", buf);

			int current_rssi = sx1272_current_rssi(&sx);
			int current_snr = sx1272_packet_snr(&sx);

			printf("RSSI: %d\n\r", current_rssi);
			printf("SNR: %d\n\r", current_snr);

			memset(buf, 0, 16);
/*
		}
		else if (mode == 2) { // RX

			HAL_GPIO_WritePin(LD2_GPIO_Port, LD2_Pin, 1);

			htim6.Instance->CNT = 0;
			HAL_TIM_Base_Start(&htim6);

			int ret = sx1272_receive_continuous(&sx, buf, true);

			HAL_TIM_Base_Stop(&htim6);

			printf("Time from last RX: %ldms\r\n", htim6.Instance->CNT / 2);

			HAL_GPIO_WritePin(LD2_GPIO_Port, LD2_Pin, 0);
			printf("RX status: %d\r\n", ret);

			for (int i=0; i<256; i++) {
				if (buf[i] == 0)
					buf[i] = ' ';
			}
			printf("Got: %.256s\r\n", buf);
			memset(buf, 0, 16);
		}
		else if (mode == 4) { // echo_src
			HAL_GPIO_WritePin(LD2_GPIO_Port, LD2_Pin, 1);
			sx1272_transmit(&sx, buf);
			printf("Sent message: %.16s\r\n", buf);

			uint8_t rcv[16];
			int ret = sx1272_receive_continuous(&sx, rcv, true);
			printf("Got: %.16s\r\n", rcv);

			HAL_GPIO_WritePin(LD2_GPIO_Port, LD2_Pin, 0);
		}

	}*/
	HAL_Delay(100);
  }
  /* USER CODE END 3 */
}

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
