ImperialSpaceSociety/Flight-Computer/Software/revision_1_rx/revision_1_rx.ioc

Mcu.UserName=STM32F446RETx
PA0-WKUP.GPIO_Label=Radio_DIO1
PA0-WKUP.Signal=GPIO_Input
PA1.GPIO_Label=Radio_DIO0
PA1.Signal=GPIO_Input
PA11.Signal=USB_OTG_FS_DM
PA12.Signal=USB_OTG_FS_DP
PA13.Signal=SYS_JTMS-SWDIO
PA14.Signal=SYS_JTCK-SWCLK
PA2.Signal=USART2_TX
PA3.Signal=USART2_RX
PA4.GPIO_Label=Radio_TX
PA4.Signal=GPIO_Input
PA5.GPIO_Label=Radio_SPI1_SCK
PA5.Signal=SPI1_SCK
PA6.GPIO_Label=Radio_SPI1_MISO
PA6.Signal=SPI1_MISO
PA7.GPIO_Label=Radio_SPI1_MOSI
PA7.Signal=SPI1_MOSI
PA8.GPIO_Label=Mag_Data_Ready
PA8.Signal=GPIO_Input
PB12.GPIO_Label=Radio_Reset
PB12.Signal=GPIO_Output
PB2.GPIO_Label=Flash_QUADSPI_CLK
PB2.Signal=QUADSPI_CLK
PB3.Signal=SYS_JTDO-SWO
PB6.GPIO_Label=Flash_QUADSPI_BK1_NCS
PB6.Signal=QUADSPI_BK1_NCS
PB7.Signal=I2C1_SDA
PB8.Signal=I2C1_SCL
PB9.GPIO_Label=Indicator_LED
PB9.Signal=GPIO_Output
PC1.GPIO_Label=Radio_DIO2
PC1.Signal=GPIO_Input
PC10.GPIO_Label=Flash_QUADSPI_BK1_IO1
PC10.Signal=QUADSPI_BK1_IO1
PC11.GPIO_Label=GPS_Reset
PC11.Signal=GPIO_Output
PC12.GPIO_Label=GPS_UART_TX
PC12.Signal=UART5_TX
PC14-OSC32_IN.GPIO_Label=Acc_Int1
PC14-OSC32_IN.Signal=GPIO_Input
PC15-OSC32_OUT.GPIO_Label=Gyro_Int3
PC15-OSC32_OUT.Signal=GPIO_Input
PC2.GPIO_Label=Radio_RX
PC2.Signal=GPIO_Output
PC4.GPIO_Label=Battery_Voltage
PC4.Signal=ADCx_IN14
PC5.GPIO_Label=Radio_Enable
PC5.Signal=GPIO_Output
PC6.GPIO_Label=Radio_DIO5
PC6.Signal=GPIO_Input
PC7.GPIO_Label=Radio_DIO4
PC7.Signal=GPIO_Input
PC8.GPIO_Label=Radio_DIO3
PC8.Signal=GPIO_Input
PC9.GPIO_Label=Flash_QUADSPI_BK1_IO0
PC9.Signal=QUADSPI_BK1_IO0
PD2.GPIO_Label=GPS_UART_RX
PD2.Signal=UART5_RX
PH0-OSC_IN.Signal=RCC_OSC_IN
PH1-OSC_OUT.Signal=RCC_OSC_OUT
