ImperialSpaceSociety/Flight-Computer/Software/revision_1/Core/Src/main.c

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
/* Includes ------------------------------------------------------------------*/
#include "main.h"
#include "usb_device.h"

/* USER CODE BEGIN Includes */
#include "stdio.h"
#include "stdlib.h"
#include "usbd_cdc_if.h"
#include "sx1272.h"
#include "L80M39.h"
#include "bme280.h"
/* USER CODE END Includes */

/* USER CODE BEGIN PD */
#define BUFFER_LENGTH 600
/* USER CODE END PD */

ADC_HandleTypeDef hadc1;

I2C_HandleTypeDef hi2c1;

QSPI_HandleTypeDef hqspi;

SPI_HandleTypeDef hspi1;

TIM_HandleTypeDef htim1;
TIM_HandleTypeDef htim2;

UART_HandleTypeDef huart5;
DMA_HandleTypeDef hdma_uart5_rx;

/* USER CODE BEGIN PV */
L80M39_t gps;
uint8_t UART1_rxBuffer[BUFFER_LENGTH] = {0};
sx1272_t sx;
sx_gpio_t sx_cs_gpio, sx_tx_gpio, sx_rx_gpio;
uint8_t buf[256] = "Hello, world!";
float temperature;
float humidity;
float pressure;

struct bme280_dev dev;
struct bme280_data comp_data;
int8_t rslt;

char hum_string[50];
char temp_string[50];
char press_string[50];
/* USER CODE END PV */

void SystemClock_Config(void);
static void MX_GPIO_Init(void);
static void MX_DMA_Init(void);
static void MX_QUADSPI_Init(void);
static void MX_I2C1_Init(void);
static void MX_SPI1_Init(void);
static void MX_ADC1_Init(void);
static void MX_UART5_Init(void);
static void MX_TIM1_Init(void);
static void MX_TIM2_Init(void);
/* USER CODE BEGIN PFP */
void HAL_UART_RxCpltCallback(UART_HandleTypeDef *huart)
{
	L80M39_parse(&gps, UART1_rxBuffer, BUFFER_LENGTH);
	char test_message[50];
	sprintf(test_message, "dat: %.2f lat: %.8f lon: %.8f", gps.datetime, gps.latitude, gps.longitude);
	CDC_Transmit_FS((uint8_t*) test_message, strlen(test_message));
	HAL_UART_Receive_DMA(&huart5, &UART1_rxBuffer[0], BUFFER_LENGTH);
}
//void HAL_TIM_PeriodElapsedCallback(TIM_HandleTypeDef *htim)
//{
//    if (htim == &htim6)
//    {
//    	HAL_TIM_PWM_Start(&htim2, TIM_CHANNEL_4);
//    }
//}
/* USER CODE END PFP */

/* USER CODE BEGIN 0 */
int8_t user_i2c_read(uint8_t id, uint8_t reg_addr, uint8_t *data, uint16_t len)
{
  if(HAL_I2C_Master_Transmit(&hi2c1, (id << 1), &reg_addr, 1, 10) != HAL_OK) return -1;
  if(HAL_I2C_Master_Receive(&hi2c1, (id << 1) | 0x01, data, len, 10) != HAL_OK) return -1;

  return 0;
}

void user_delay_ms(uint32_t period)
{
  HAL_Delay(period);
}

int8_t user_i2c_write(uint8_t id, uint8_t reg_addr, uint8_t *data, uint16_t len)
{
  int8_t *buf;
  buf = malloc(len +1);
  buf[0] = reg_addr;
  memcpy(buf +1, data, len);

  if(HAL_I2C_Master_Transmit(&hi2c1, (id << 1), (uint8_t*)buf, len + 1, HAL_MAX_DELAY) != HAL_OK) return -1;

  free(buf);
  return 0;
}

/* USER CODE END 0 */

/**
  * @brief  The application entry point.
  * @retval int
  */
int main(void)
{
  /* MCU Configuration--------------------------------------------------------*/

  /* Reset of all peripherals, Initializes the Flash interface and the Systick. */
  HAL_Init();

  /* Configure the system clock */
  SystemClock_Config();

  /* Initialize all configured peripherals */
  MX_GPIO_Init();
  MX_DMA_Init();
  MX_QUADSPI_Init();
  MX_I2C1_Init();
  MX_SPI1_Init();
  MX_ADC1_Init();
  MX_UART5_Init();
  MX_USB_DEVICE_Init();
  MX_TIM1_Init();
  MX_TIM2_Init();
  /* USER CODE BEGIN 2 */
  //__HAL_TIM_CLEAR_IT(&htim6, TIM_IT_UPDATE);
  //HAL_TIM_Base_Start_IT(&htim6);

  /* BME280 init */
    dev.dev_id = BME280_I2C_ADDR_PRIM;
    dev.intf = BME280_I2C_INTF;
    dev.read = user_i2c_read;
    dev.write = user_i2c_write;
    dev.delay_ms = user_delay_ms;

    rslt = bme280_init(&dev);

    /* BME280 settings */
    dev.settings.osr_h = BME280_OVERSAMPLING_1X;
    dev.settings.osr_p = BME280_OVERSAMPLING_16X;
    dev.settings.osr_t = BME280_OVERSAMPLING_2X;
    dev.settings.filter = BME280_FILTER_COEFF_16;
    rslt = bme280_set_sensor_settings(BME280_OSR_PRESS_SEL | BME280_OSR_TEMP_SEL | BME280_OSR_HUM_SEL | BME280_FILTER_SEL, &dev);

	//HAL_GPIO_WritePin(Radio_Enable_GPIO_Port, Radio_Enable_Pin, SET);

  sx_cs_gpio = (sx_gpio_t) {
		.port = Radio_Enable_GPIO_Port,
		.pin = Radio_Enable_Pin,
	};

	sx_tx_gpio = (sx_gpio_t) {
		.port = Radio_TX_GPIO_Port,
		.pin = Radio_TX_Pin,
	};

	sx_rx_gpio = (sx_gpio_t) {
		.port = Radio_RX_GPIO_Port,
		.pin = Radio_RX_Pin,
	};

	// Init device structure

	sx = (sx1272_t) {
			.spi = &hspi1,
			.cs_gpio = &sx_cs_gpio,
			.tx_gpio = &sx_tx_gpio,
			.rx_gpio = &sx_rx_gpio,
			.packet_length = 16,
	};

	/*printf("tx (1), rx (2), tx_no_crc (3), echo_src (4), echo_wall (5) ? ");
	fflush(stdout);*/
	int status = sx1272_common_init(&sx, false);
	HAL_GPIO_WritePin(GPS_Reset_GPIO_Port, GPS_Reset_Pin, 1);
	L80M39_init(&gps);
	HAL_UART_Receive_DMA(&huart5, &UART1_rxBuffer[0], BUFFER_LENGTH);
  /* USER CODE END 2 */

  /* Infinite loop */
  /* USER CODE BEGIN WHILE */
  unsigned int counter = 0;
  char test_message[50];
  while (1)
  {
    /* USER CODE END WHILE */

    /* USER CODE BEGIN 3 */

	  rslt = bme280_set_sensor_mode(BME280_FORCED_MODE, &dev);
	  dev.delay_ms(40);
	  /*Get Data */
	  rslt = bme280_get_sensor_data(BME280_ALL, &comp_data, &dev);
	  if(rslt == BME280_OK)
	  {
		temperature = comp_data.temperature / 100.0;
		humidity = comp_data.humidity / 1024.0;
		pressure = comp_data.pressure / 10000.0;
	  } else {
//		  if (HAL_UART_Transmit(&huart2, "Error ", 6, 100)) {
//			  Error_Handler();
//			  HAL_Delay(500);
//		  }
	  }

	  unsigned int latitudeInt = *(unsigned int*)&gps.latitude;
	  unsigned int longitudeInt = *(unsigned int*)&gps.longitude;
	  unsigned int dateInt = *(unsigned int*)&gps.datetime;
	  unsigned int tempInt = *(unsigned int*)&temperature;
	  unsigned int humidityInt = *(unsigned int*)&humidity;
	  unsigned int pressureInt = *(unsigned int*)&pressure;

	  buf[0] = 0x10;
	  buf[1] = 0x00;
	  buf[2] = 0x00;
	  buf[3] = 0x00;
	  buf[4] = latitudeInt & 0xff;
	  buf[5] = (latitudeInt >> 8) & 0xff;
	  buf[6] = (latitudeInt >> 16) & 0xff;
	  buf[7] = (latitudeInt >> 24) & 0xff;
	  buf[8] = longitudeInt & 0xff;
	  buf[9] = (longitudeInt >> 8) & 0xff;
	  buf[10] = (longitudeInt >> 16) & 0xff;
	  buf[11] = (longitudeInt >> 24) & 0xff;
	  buf[12] = dateInt & 0xff;
	  buf[13] = (dateInt >> 8) & 0xff;
	  buf[14] = (dateInt >> 16) & 0xff;
	  buf[15] = (dateInt >> 24) & 0xff;
	  int ret = sx1272_transmit(&sx, buf);

	HAL_Delay(100);

	  buf[0] = 0x20;
	  buf[1] = 0x00;
	  buf[2] = 0x00;
	  buf[3] = 0x00;
	  buf[4] = tempInt & 0xff;
	  buf[5] = (tempInt >> 8) & 0xff;
	  buf[6] = (tempInt >> 16) & 0xff;
	  buf[7] = (tempInt >> 24) & 0xff;
	  buf[8] = humidityInt & 0xff;
	  buf[9] = (humidityInt >> 8) & 0xff;
	  buf[10] = (humidityInt >> 16) & 0xff;
	  buf[11] = (humidityInt >> 24) & 0xff;
	  buf[12] = pressureInt & 0xff;
	  buf[13] = (pressureInt >> 8) & 0xff;
	  buf[14] = (pressureInt >> 16) & 0xff;
	  buf[15] = (pressureInt >> 24) & 0xff;
	  ret = sx1272_transmit(&sx, buf);

	sprintf(test_message, "Tx status: %d\r\n", ret);
	CDC_Transmit_FS((uint8_t*) test_message, strlen(test_message));
	sprintf(test_message, "Datetime: %x\n\r", dateInt);
	CDC_Transmit_FS((uint8_t*) test_message, strlen(test_message));
	sprintf(test_message, "temperature: %4.2f, humidity: %4.2f, pressure: %4.2f\r\n", temperature, humidity, pressure);
	CDC_Transmit_FS((uint8_t*) test_message, strlen(test_message));
	sprintf(test_message, "temperature: %x, humidity: %x, pressure: %x\r\n", tempInt, humidityInt, pressureInt);
	CDC_Transmit_FS((uint8_t*) test_message, strlen(test_message));
//	sprintf(test_message, "Latitude: %x\n\r", latitudeInt);
//	CDC_Transmit_FS((uint8_t*) test_message, strlen(test_message));
//	sprintf(test_message, "Longitude: %x\n\r", longitudeInt);
//	CDC_Transmit_FS((uint8_t*) test_message, strlen(test_message));


	HAL_Delay(100);
	counter++;
	// Buzzer will start in 15min //4500
	if(counter == 4500) {
		HAL_TIM_PWM_Start(&htim2, TIM_CHANNEL_4);
	}
  }
  /* USER CODE END 3 */
}

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
