ImperialSpaceSociety/Flight-Computer/(commit log)

2023-01-24 Dev board code
    [circuit board design v1.0.kicad_pcb, circuit board design v1.0.kicad_sch, gps_ublox.kicad_sch, mcu_stm32.kicad_sch]
2023-01-28 Added new diagram and symbol library
    [circuit board design v1.0.kicad_sch, gps.kicad_sch, imu.kicad_sch, mcu_stm32.kicad_sch, power_supply.kicad_sch, sensors.kicad_sch]
2023-01-30 power management schematic done
    [circuit board design v1.0.kicad_sch, mcu_stm32.kicad_sch, power_supply.kicad_sch]
2023-02-21 Changes on 14/02/2023
    [circuit board design v1.0.kicad_sch, mcu_stm32.kicad_sch, sensors.kicad_sch]
2023-02-21 BMI088 schematic
    [circuit board design v1.0.kicad_pcb, circuit board design v1.0.kicad_sch, gps.kicad_sch, mcu_stm32.kicad_sch, power_supply.kicad_sch, sensors.kicad_sch]
2023-02-28 Continued layout for PCB
    [circuit board design v1.0.kicad_sch, mcu_stm32.kicad_sch, sensors.kicad_sch]
2023-02-28 Added buzzer transistor footprint
    [circuit board design v1.0.kicad_sch, mcu_stm32.kicad_sch, sensors.kicad_sch]
2023-04-01 Created stm32mx project and started on layout
    [105017-0001.stp, L80-R--3DModel-STEP-56544.STEP, circuit board design v1.0.kicad_pcb, circuit board design v1.0.kicad_sch, gps.kicad_sch, mcu_stm32.kicad_sch, power_supply.kicad_sch, sensors.kicad_sch]
2023-04-01 Added spi connection for radio
    [circuit board design v1.0.kicad_pcb, circuit board design v1.0.kicad_sch, mcu_stm32.kicad_sch]
2023-04-08 Placed components but not connected yet
    [ECS-80-8-33Q-ADS-TR3.stp, circuit board design v1.0.kicad_pcb, sensors.kicad_sch]
2023-04-08 Finished routing
    [2N7002-7-F.stp, BMI088.stp, DFLT27A-7.stp, JST_PH_B2B-PH-K_1x02_P2.00mm_Vertical.step, JST_PH_B4B-PH-K_1x04_P2.00mm_Vertical.step, PinHeader_2x03_P2.54mm_Vertical.step, R_0603_1608Metric.step, circuit board design v1.0.kicad_pcb]
2023-04-09 Added crystal 3d model to layout
    [circuit board design v1.0.kicad_pcb]
2023-04-22 Changed connectors to horizontal
    [SDR08540M3-01.stp, circuit board design v1.0.kicad_pcb, circuit board design v1.0.kicad_sch, mcu_stm32.kicad_sch, power_supply.kicad_sch]
2023-04-22 Added extra cap in case its needed
    [NCP161ASN180T1G.stp, TSOP-6_1.65x3.05mm_P0.95mm.step, circuit board design v1.0.kicad_pcb, circuit board design v1.0.kicad_sch, gps.kicad_sch, power_supply.kicad_sch]
2023-04-23 Added connector 3d models
    [JST_PH_S2B-PH-K_1x02_P2.00mm_Horizontal.step, JST_PH_S4B-PH-K_1x04_P2.00mm_Horizontal.step, circuit board design v1.0.kicad_pcb]
2023-04-29 Redid footprint for buzzer
    [circuit board design v1.0-B_Cu.gbr, circuit board design v1.0-B_Mask.gbr, circuit board design v1.0-B_Paste.gbr, circuit board design v1.0-B_Silkscreen.gbr, circuit board design v1.0-Edge_Cuts.gbr, circuit board design v1.0-F_Cu.gbr, circuit board design v1.0-F_Mask.gbr, circuit board design v1.0-F_Paste.gbr]
2023-04-30 Added radio connections to pcb and code
    [DF13-10P-1.25DS_20_.stp, LIS3MDLTR.step, circuit board design v1.0.kicad_pcb, circuit board design v1.0.kicad_sch, gps.kicad_sch, gps_ublox.kicad_sch, imu.kicad_sch, mcu_stm32.kicad_sch]
2023-05-01 Design before mounting radio on surface
    [circuit board design v1.0.kicad_pcb]
2023-05-04 Added routing for radio module on back of pcb
    [2SCR512RHZG.step, U.FL-R-SMT-1_10_.stp, circuit board design v1.0.csv, circuit board design v1.0.kicad_pcb, circuit board design v1.0.kicad_sch, mcu_stm32.kicad_sch]
2023-05-05 PCB sent for production
    [circuit board design v1.0-B_Cu.gbr, circuit board design v1.0-B_Mask.gbr, circuit board design v1.0-B_Paste.gbr, circuit board design v1.0-B_Silkscreen.gbr, circuit board design v1.0-Edge_Cuts.gbr, circuit board design v1.0-F_Cu.gbr, circuit board design v1.0-F_Mask.gbr, circuit board design v1.0-F_Paste.gbr]
2023-05-16 Realigned bottom left hole
    [circuit board design v1.0.kicad_pcb]
2023-05-27 Created new project for pcb v2
    [105017-0001.stp, 2N7002-7-F.stp, 2SCR512RHZG.step, BMI088.stp, C_0603_1608Metric.step, DF13-10P-1.25DS_20_.stp, DFLT27A-7.stp, ECS-80-8-33Q-ADS-TR3.stp]
2023-05-27 Found error transistor pinout
    [circuit board design v2.1.kicad_pcb, circuit board design v2.1.kicad_sch, mcu_stm32.kicad_sch, sensors.kicad_sch]
2023-05-28 Renamed pins in stm32cubeide and finished routing for V2.1
    [circuit board design v2.1.kicad_pcb, circuit board design v2.1.kicad_sch, gps.kicad_sch, mcu_stm32.kicad_sch, power_supply.kicad_sch]
2023-05-29 Added interupt pins to from BMI088 and LIS
    [circuit board design v2.1.kicad_pcb, circuit board design v2.1.kicad_sch, mcu_stm32.kicad_sch, power_supply.kicad_sch, sensors.kicad_sch]
2023-06-02 Code tested with stm32cubeide workspace_1.12.1
2023-06-02 Added solder jumpers
    [circuit board design v2.1.kicad_pcb, circuit board design v2.1.kicad_sch, mcu_stm32.kicad_sch]
2023-06-03 PCB V2.1 sent for manufacture
    [circuit board design v2.1-B_Cu.gbr, circuit board design v2.1-B_Mask.gbr, circuit board design v2.1-B_Paste.gbr, circuit board design v2.1-B_Silkscreen.gbr, circuit board design v2.1-Edge_Cuts.gbr, circuit board design v2.1-F_Cu.gbr, circuit board design v2.1-F_Mask.gbr, circuit board design v2.1-F_Paste.gbr]
2023-06-19 Added freeRTOS
    [mcu_stm32.kicad_sch]
2023-06-30 FCS-v2 with thread-safe USB logging capabilities
2023-07-01 Add sx1272 driver code folder
2023-07-01 Add compile-time switch to choose between printf/USB (staging)
2023-07-01 add GPS DMA code
2023-07-01 Add best-effort stack overflow checking and debug UART on PA9, PA10
2023-07-05 add transmission from the PCB and receive from the dev board
2023-07-06 add receive project that can be uploaded onto the PCB
2023-07-08 Added UART print for serial logging
2023-07-08 Delay for start of buzzer
    [main.c, main.h, revision_1.ioc]
2023-07-08 Attempted to integrate BME280 but not working
    [main.c]
2023-10-28 Fixed error in sx1272 library
    [sx1272.c]
2023-10-28 add documentation and receiver pinout
    [Bill_of_materials.xlsx, Centering ring v4.f3d, Centering ring with motor hook slots v8.f3d, Cesaroni 29Pro 2G casing v3.f3d, Cesaroni 29Pro 2G regular closure v3.f3d, Electronics Bay V2 PCB v11 v1.f3d, Engine Block Layer Plywood v4.f3d, Motor Hook v8.f3d]
2024-07-31 Added enclosure 3d files
    [Electronics+Bay+V2+PCB.f3z, Electronics+Bay+V2+PCB.stl]
