ImperialSpaceSociety/Flight-Computer/(notices)

Notices in the files:
Hardware/circuit board design v2.1/Component_3d_models/R_0603_1608Metric.step:
Copyright (C) 2018, kicad StepUp
This work is licensed under the [Creative Commons CC-BY-SA 4.0 License](https://creativecommons.org/licenses/by-sa/4.0/legalcode),
with the following exception:
To the extent that the creation of electronic designs that use 'Licensed Material' can be considered to be 'Adapted Material',
You are free to use the library data in your own projects without the obligation to share your project files under this or any other license agreement.
Hardware/circuit board design v2.1/Component_3d_models/JST_PH_S2B-PH-K_1x02_P2.00mm_Horizontal.step:
Copyright (C) 2017, Rene Poeschl
Hardware/circuit board design v2.1/Component_3d_models/PinHeader_2x03_P2.54mm_Vertical.step:
Copyright (C) 2017, kicad StepUp
Software/revision_1/Core/Inc/main.h:
Copyright (c) 2023 STMicroelectronics.
All rights reserved.
This software is licensed under terms that can be found in the LICENSE file
parts and their libraries:
Copyright 2021 Accelerated Designs. All rights reserved.
